Prajwal-Chandrashekhar-Wani/Pump-Lifting-Mechanism-/README.md

# Pump-Lifting-Mechanism-
This project focuses on the design and development of a manual/mechanically operated pump lifting mechanism for safe and efficient removal or installation of submersible pumps in Well and Borewell
