Prajwal-Chandrashekhar-Wani/Pump-Lifting-Mechanism-/Design and Analysis of a Tractor1.pdf

# Vishwakarma Institute of Technology

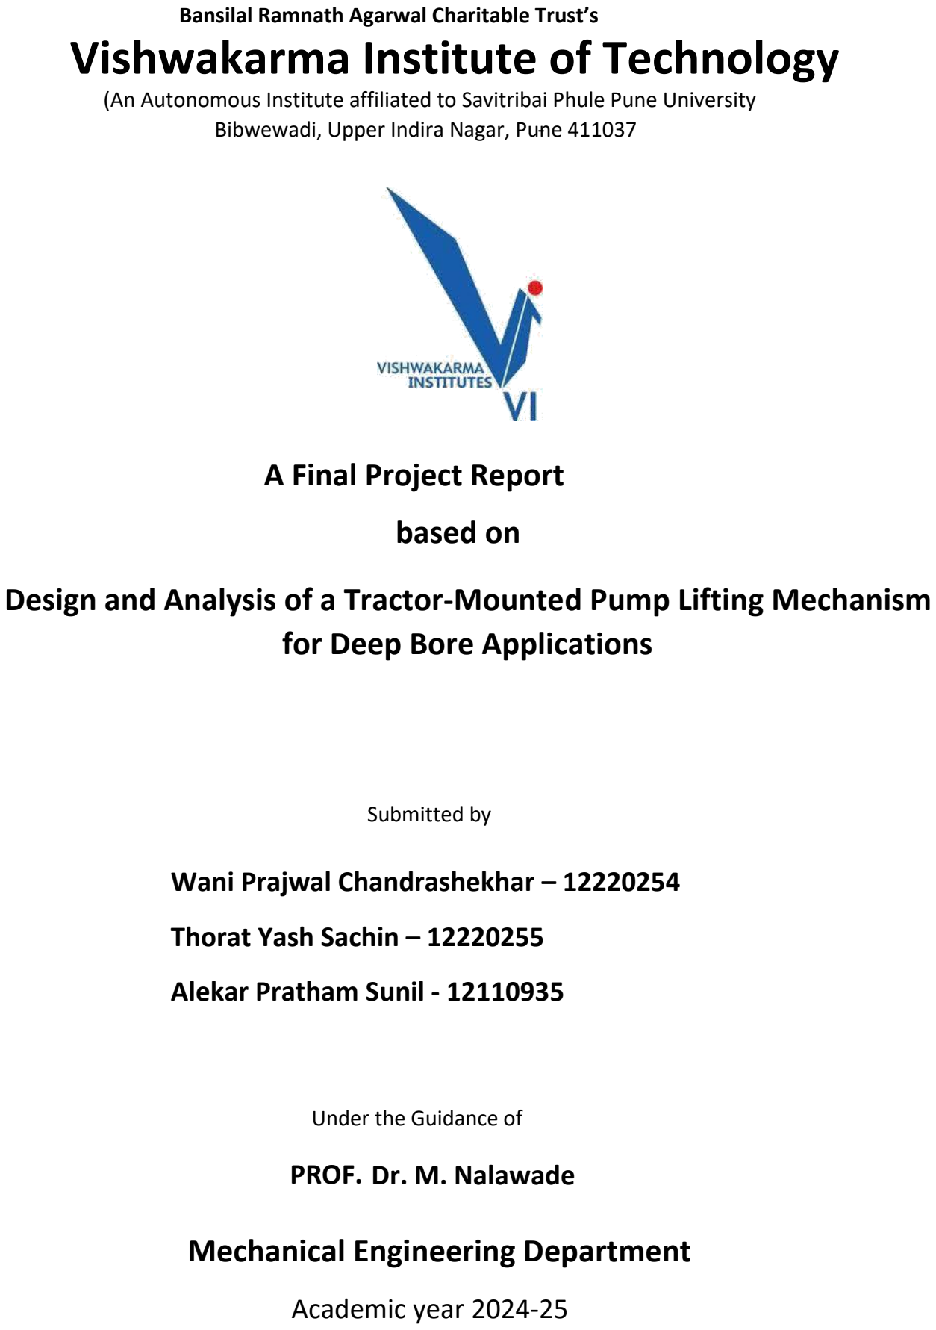
[picture p1: page 1]

Bansilal Ramnath Agarwal Charitable Trust’s

(An Autonomous Institute affiliated to Savitribai Phule Pune University Bibwewadi, Upper Indira Nagar, Pune 411037 -

## A Final Project Report

## based on

## Design and Analysis of a Tractor-Mounted Pump Lifting Mechanism for Deep Bore Applications

Submitted by

### Wani Prajwal Chandrashekhar – 12220254

### Thorat Yash Sachin – 12220255

### Alekar Pratham Sunil - 12110935

Under the Guidance of

### PROF. Dr. M. Nalawade

## Mechanical Engineering Department

### Academic year 2024-25

BANSILAL RAMNATH AGARWAL CHARITABLE TRUST’S

### VISHWAKARMA INSTITUTE OF TECHNOLOGY

PUNE-411 037

(An Autonomous Institute Affiliated to Savitribai Phule Pune University)

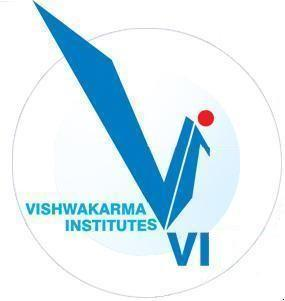
[picture p2: figure]

CERTIFICATE

This is to certify that the Project titled “Design and Analysis of a Tractor-Mounted Pump Lifting

Mechanism for Deep Bore Applications” has been completed in the academic year 2024 – 2025, by WANI

PRAJWAL CHANDRASHEKHAR (GR No: 12220254, Roll NO: 88), in partial fulfilment of B. Tech in Mechanical

Engineering as prescribed by Savitribai Phule Pune University.

Prof. M. Nalawade
Institute Guide,
Examiner | Prof. (Dr.) D. B. Hulwan Head of Department,
| Mechanical
Place: Pune | Date: /5//2025

# ACKNOWLEDGMENT

I would like to express my deepest gratitude to Dr. D. B. Hulwan, Head of the Department of Mechanical Engineering, for his unwavering support, guidance, and for granting me the permission to undertake this project. His encouragement and leadership have been instrumental in shaping the direction and success of this endeavor.

### My heartfelt thanks also go to Prof. (Dr.) M. Nalawade, Project Coordinator and College

Guide at Vishwakarma Institute of Technology, for his invaluable mentorship throughout the course of this project. His expert advice, constant encouragement, and constructive feedback greatly enhanced the quality of my work. I am truly fortunate to have worked under his guidance.

I am also grateful to all the faculty members and staff of the Mechanical Engineering Department for their support, insights, and for providing a learning environment conducive to innovation and growth.

I would like to extend special thanks to all those who, directly or indirectly, contributed to the successful completion of my final year project. Their assistance, encouragement, and cooperation made a significant difference in overcoming the challenges faced during various stages of the project.

### This project has provided me with a unique opportunity to apply theoretical knowledge to

practical scenarios. The skills, insights, and hands-on experience I have gained throughout this journey will be cherished and will continue to influence my professional and academic growth in the years to come.

Finally, I am thankful to my peers, friends, and family members whose moral support and motivation helped me stay focused and driven throughout these endeavours.

## Article

## Design and Analysis of a Tractor-Mounted Pump Lifting Mechanism for Deep Bore Applications

Wani Prajwal ¹

, Thorat Yash ²

, Alekar Pratham ³

, Nalawade Mukund ⁴

1. Vishwakarma Institute of Technology, Mechanical dept. Pune, India prajwal.wani22@vit.edu
2. Vishwakarma Institute of Technology, Mechanical dept. Pune, India yash.thorat22@vit.edu
3. Vishwakarma Institute of Technology, Mechanical dept. Pune, India pratham.alekar21@vit.edu
4. Vishwakarma Institute of Technology, Mechanical dept. Pune, India nalwade.mukund22@vit.edu
- Correspondence: prajwal.wani22@vit.edu

Featured Application: The current research may serve as a reference to the loading and lifting equipment Design and Analysis of a Tractor-Mounted Pump Lifting Mechanism for Deep Bore Applications

Abstract - Submersible pumps installed for farming irrigation through borewells tend to have to be withdrawn from time to time for upkeep. Conventional manual lifting proves to be an energy-intensive process. This work brings forth the design and testing of a half-automatic tractor- mounted pump lift system specifically adapted to deep bore use. The mechanism uses a PTO-powered rope drum, bevel gear system, and worm and worm wheel setup to hoist loads of 150 kg at a depth of 100 feet. The 6×19 IWRC steel wire rope was chosen for strength, fatigue, and abrasion. The torque calculation, drum size selection, fatigue bending analysis, and rope selection were done in accordance with global standards. The mechanism provides a safe, energy-saving solution for remote or rural locations that maximizes both safety and maintenance ease.

Keywords: Semi-automatic lifting system, tractor PTO, borewell pump retrieval, steel wire rope design, agricultural engineering, rural water systems.

### Introduction

The design of effective and dependable lifting devices has been the subject of many studies in areas ranging from heavy construction, rural water supply, to automated material handling. Researchers have attempted structural optimization, dynamic control
systems, | safety | methods, | and | mechanical
advancements to enhance performance, save costs, and increase usability in real-world applications.

Reliability-based structural optimization has been an important research area in heavy lifting systems. A robust design optimization (RBDO) framework wasadopted for crawler cranes' lattice booms for which weight reduction was attained while not compromising on safety by combining probabilistic restrictions like strength, stiffness, overall stability, and compressive-bending reliability. The method also proved to efficiently achieve up to 9.62% reduction in weight by keeping the reliability index greater than 4.364, with still attaining a 2.8% reduction at an even more cautious reliability level, providing huge savings in material as well as costs [1]. (https://doi.org/10.1016/j.istruc.2020.12.024)

In crane operation and motion control, dynamic modeling with wire rope elasticity was brought into play to improve the simulation of crane behavior under sophisticated conditions. This model enabled the creation of high-performance robust sliding mode control (SMC) algorithms such as standard, terminal, and fast terminal SMC that handled multiple degrees of freedom like boom luffing, cargo-lifting, and swing suppression at the same time. [1]. (https://doi.org/10.1016/j.istruc.2020.12.024) These strategies showed high precision in motion coordination while minimizing oscillations, ensuring system stability in dynamic environments [2]. (https://doi.org/10.1016/j.ymssp.2017.09.045)

Crane safety has also been extensively reviewed, highlighting a gap in the attention given to non-technical risk dimensions. While equipment-related hazards were well covered, other factors such as operator behavior, environmental conditions, and regulatory deficiencies received relatively little scholarly focus. Eight significant research gaps were
identified, | urging | a | shift | toward | a | more
multidisciplinary approach in crane safety research to better prevent accidents and improve operational guidelines [3]. (https://doi.org/10.1016/j.ssci.2020.105002) Complementary to this, practical literature has provided detailed engineering insights into components such as wire ropes, drives, and
maintenance | practices, | supporting | the
implementation of safer and longer-lasting crane systems [4]. (https://www.wiley.com/en-us/Cranes%3A+Design%2C+Practice%2C+and+Maintenance%2C+2nd+Edition-p-9781860583735)

Parallel advancements have been made in the field of pump and water lifting mechanisms. A deep-sea motor pump utilizing an increased flowrate approach was designed to expand passage dimensions, enabling the transport of coarse particles and improving anti-blocking performance. A six-stage pump configuration was validated through experiments, confirming its ability to handle suspended particles without motor overload—demonstrating the design’s effectiveness in particle-laden environments [5]. (https://doi.org/10.1016/j.apor.2018.10.018)

Automation and predictability in small-scale lifting systems have also been examined. An electric motor power-driven, mechanical lift automation system with a 1-hp motor and a counterweight scheme was established in industrial material handling. The third-order polynomial character of the lift time vs load relationship and multiple operating zones present in the lift cycle were seen in experiment outcomes. This improves the understanding of load behavior trends and efficiency performance in low-capacity automated systems [6]. (https://www.researchgate.net/publication/342155446_Development_of_an_automated_mechanical_lift_for_material_handling_purposes)

Hydraulic lifting circuits widely employed by cranes are strongly affected by the mechanical properties of steel wire ropes. Investigation showed that the pre-tensioning of hoisting ropes has a remarkable effect on minimizing peak dynamic loads and stabilization
time—by | 92.6% | and | 49%, | respectively—
demonstrating the significance of wire rope layout in system dynamics. Comparatively, rope stiffness increase affected the system to a relatively lesser extent, demonstrating that initial tension is a more significant parameter for performance adjustment [7]. (https://www.researchgate.net/publication/348549539_Analysis_of_the_influence_on_the_hydraulic_lifting_circuit_of_the_boom_crane_when_the_characteristics_of_th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)

Applications of bore well have motivated various innovations with respect to affordability, portability, and simplicity. A low-cost compact bore well pump lifting mechanism was developed for rural and small-scale users with low cost and less labor demand. The system is effective in enabling easy installation and removal of submersible pumps, thereby lessening the reliance on manual processes [8]. (https://www.jetir.org/papers/JETIR1904995.pdf) In another connected development, a wind-energy-water-lifting-pump mechanism was suggested, employing rotating foils and a piston-linear drive to harness the mechanical energy of the wind as a means to extract usable water—acting as a renewable solution to far-off water acquisition [9]. (https://ijste.org/articles/IJSTEV2I12236.pdf)

To surpass the shortcomings of conventional lifting systems, a review of bore well pump installation methods cited disadvantages in mechanisms such as chain pulleys and hydraulic lifters. A recently suggested automated machine overcame such shortcomings with its compact size and tool-free assembly/disassembly, which suited confined or rural settings [10]. (https://ijsrd.com/articles/IJSRDV3I80018.pdf) The design was further improved upon with the creation of a gear-powered submersible pump lift machine that could lift pumps from 300 ft deep bore wells using only two workers. Working at a rate greater than 3 meters per minute, the machine was ten times more efficient than the conventional system and did not require any special tools—something that made it ideal for use in rural agriculture [11]. (https://matjournals.co.in/index.php/JoIM/article/view/6485)

The literature reviewed as a whole highlights the increasing interest in improving efficiency, safety, and automation in bore well operations and farm machinery, especially in pipe lifting mechanisms and tractor-based systems.

Bajbalkar and Bhajibhakare et.al [12] (https://ijariie.com/AdminUploadPdf/Review_on_Modeling_of_Mechanism_for_Installation_and_Lifting_of_Bore_Well_Pipe_and_Submersible_Pump_ijariie9894.pdf) propose an inclusive summary of present techniques of installation and hoisting of bore well pipes and submersible pumps, identifying major disadvantages of available methods, which are very manpower-intensive, time-consuming, and inefficient. They stress the imminent need for a compact, affordable mechanism to minimize manpower and cost of operations. Similarly Choure and Kale [17] (https://ijariie.com/AdminUploadPdf/Review_on_Bore_Well_Pipe_Lifting_and_Transportation_Machine_ijariie8295.pdf) suggest a motor-operated bore well pipe lifting and transporting machine, having a gear and roller operated lifting mechanism.The mechanism lifts automatically at a speed of more than 3 meters per minute, lifts the load of 100 to 1000 kg, and has the features of safety devices such as adjustable pressure rollers and a worm gearbox. Its simplicity is low-cost and appropriate for rural and limited-space operations, providing a significant improvement over conventional chain pulley system.

Moving to farm machinery, Cong et al. [13] (https://www.mdpi.com/2076-3417/11/20/9758) discuss the shortcomings of traditional testing techniques for hydraulic linkages in high- and medium-horsepower tractors. They created a test device using a four-bar mechanism to assess load-lifting performance. The system decreases detection time considerably and does away with manual connection between the tractor and the load, thus enhancing efficiency and safety in hydraulic system testing. Structural optimization and analysis, Tarighi et al. [14] (https://www.researchgate.net/publication/288920111_Optimization_of_a_Lower_Hitch_Link_for_a_Heavy_Duty_Tractor_Using_Finite_Element_Method) used finite element analysis to find the optimal design for the lower hitch link of a heavy-duty tractor. Two materials, CK45 and 945M38, were compared under the same stress conditions. Although both materials were able to endure one million cycles of loading, 945M38 showed a much greater factor of safety (5.13) and hence is an appropriate material for durability and reliability under tough, demanding applications. Likewise, Seyedabadi
[15] (https://link.springer.com/article/10.1007/s11668-015-0010-0) performed a finite element analysis of the MF-285 tractor lift arm. The results showed that although the arm is safe for normal plow loads (500 kg), it is not structurally sufficient for the maximum hydraulic capacity of the tractor, which is 2230 kg. The research advises either reducing the lifting capacity to 1430 kg, thus having a minimum safety factor of 1.5, or re-engineering the lift arm for increased strength.

In addition, Bentaher et al. [16] presented a new instrumentation system for the three-point hitch mechanism of tractors to optimize tillage operations. The system uses only three force transducers to measure the three orthogonal components of tillage force—longitudinal, lateral, and vertical. A key advantage of this system is its ability to detect asymmetrical loading caused by implements like mouldboards, through differences in the lift arm reactions. Calibration results confirmed its accuracy, with errors below 2.8% for vertical force measurements and a maximum of 13% for the lowest force, demonstrating the system’s practicality and reliability in field applications.

### Device Design

The Tractor (model 5050E, JOHN DEERE) widely used in large and medium horsepower tractors is adopted during the present study. The lifting torque and Speed range of the device used in the test is 126Nm and 540rpm.

Test Requirements | Index
Maximum Weight to Lift | 150 kg
Lifting Height | 100 feet
Maximum Lifting Torque | 126Nm
Speed | 2100rpm

Principle of Design:

Based on field observations and insights from relevant literature, the process of lifting submersible pumps from deep bore wells involves two primary stages: the connection of the lifting mechanism to the pump assembly and the subsequent lifting operation. The initial stage includes securely attaching the lifting rope or hook to the pump or pipe. The mechanism designed in the present study is mounted on a tractor and focuses on providing a simple, safe, and efficient solution for lifting pumps without the need for manual excavation or trenching at the bore site. This not only enhances safety but also minimizes site disruption during pump installation and retrieval.

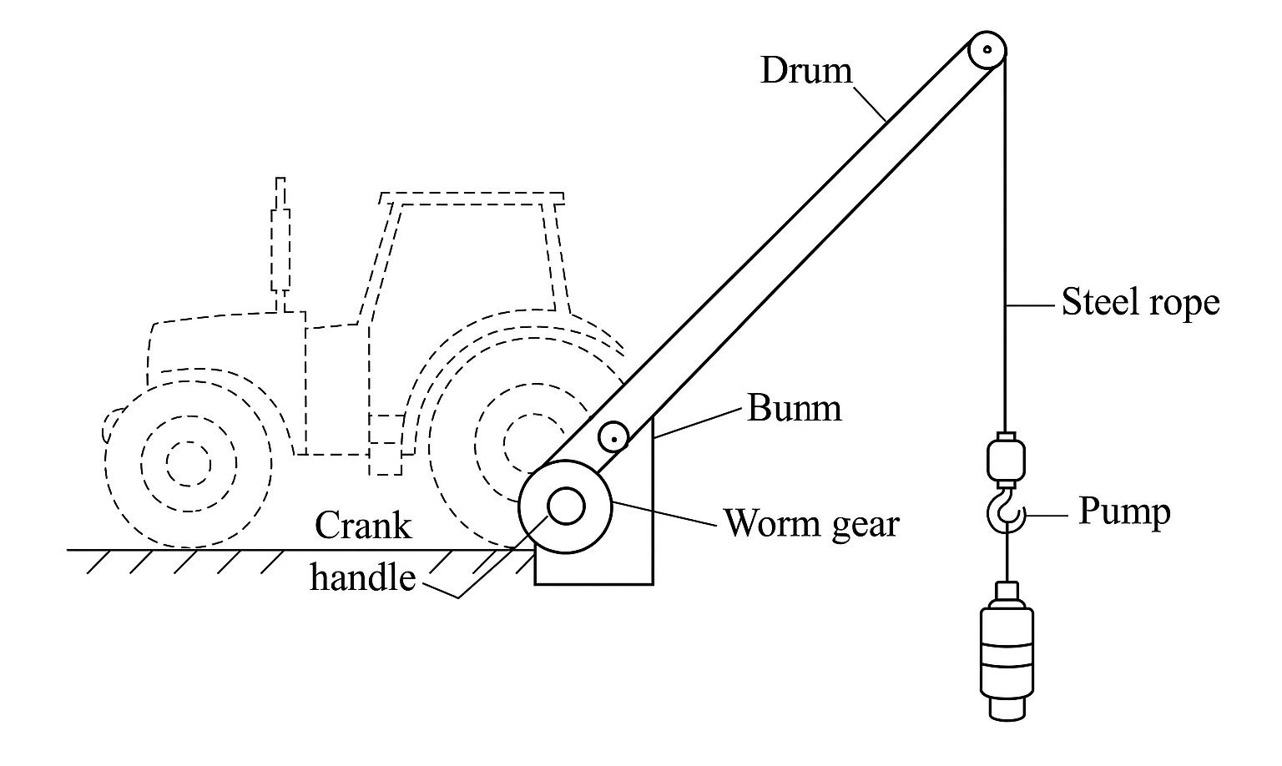
[picture p3: figure]

Fig no: 1 Design Assembly of Tractor Mounted Pump Lifting Mechanism

### Components to Design: -

PTO Shaft, Worm & Worm Wheel, Bevel Gear, Spline, Hand Lever, Drum, Steel Rope, Pulley, Crane Boom.

Work on Design Data
Pump to Lift | 150Kg (1470.9975N)
Depth | 100feet (30.48m)
Tractor Torque | 126Nm
Hand Torque | -
Table no 1: Design Data

The weight of the Pump that is transferred through the pulley

Work on the Design Data of Pulley Load
Coefficient of Friction (μ) | 0.3
Tmin | 1471N
Contact | 135Deg
Tmax | 2651.1N
Table no 2: Design Data of Pulley
Rope Material | Rope Material | Rope Material
Steel rope on steel pulley (dry) | Steel | 0.15 to 0.25
Steel rope on steel pulley (oil) | Steel | 0.05–0.08
Nylon rope on steel pulley | Steel | 0.08 to 0.15
Cotton rope on wood pulley | Wood | 0.25-0.4
Table no 3: Steel Rope Friction Factor

Tmax

Tmin

= e

μ.θ

Tmax
1471 = e

0.25×135×(

3.14
180)

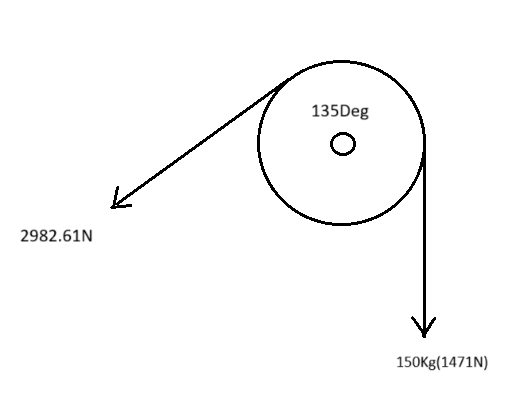
[picture p4: figure]

Fig no 2: Friction in Rope and Pulley

### 1. PTO Shaft: -

Power (KW) | 27.6
Speed (rpm) | 2100
Torque (Nm) | 126

Table no 4: PTO Shaft Design Data

Torque (Nm) =

9550 × Power (kW)
Speed (rpm)

Torque (Nm) =

9550 × 27.6
2100

Torque (Nm) = 126Nm

Maximum Length of Shaft: | 1447.8 (57")
Minimum Length of Shaft: | 889mm (35")

Table no 5: Length of PTO Shaft

Where ,

D = major diameter of splines (mm) | d = minor diameter of splines (mm)
l = length of hub (mm) | n = number of splines
Mt = transmitted torque (N-mm) | pm = permissible pressure on spline (N/mm2)
A = total area of splines (mm2) | Rm = mean radius of splines (mm)

The Permissible pressure on the Splines is Limited to 6.5 N/mm²

Mt =

1
8

pm ln (D

2 − d

2
)

Mt =

1
8

6.5 × 76 × 6 (34.87² − 27.89² )

Mt = 162303 Nmm << 126000 Nmm

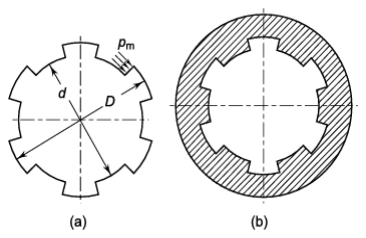
[picture p5: figure]

Fig no 3: Spline Dimensions

Assume allowable shear stress τmax = 40 MPa = 40 N/mm2 (typical for mild steel in conservative design)

T =

π
16

× τ ×

D

4 − d

4
D

126000 =

π
16

× 40 ×

D

4 − 29.65⁴
D
D = 38.08 mm

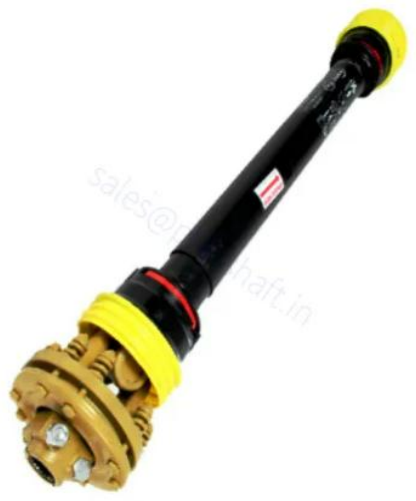
[picture p6: figure]
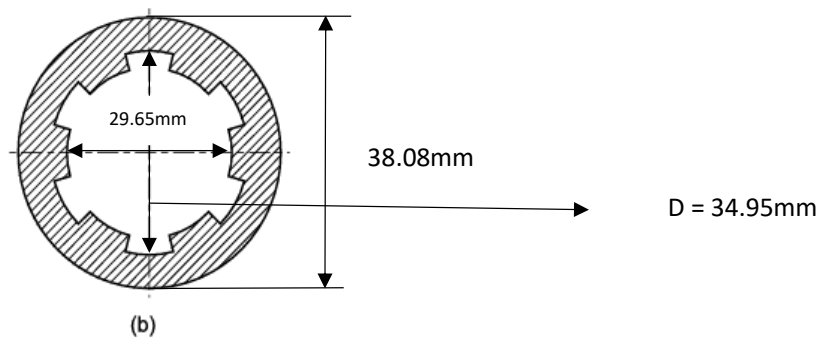
[picture p7: figure]

Fig no 4: Actual Spline Design for PTO Shaft | Fig no 5: How Actually a PTO Shaft Looks

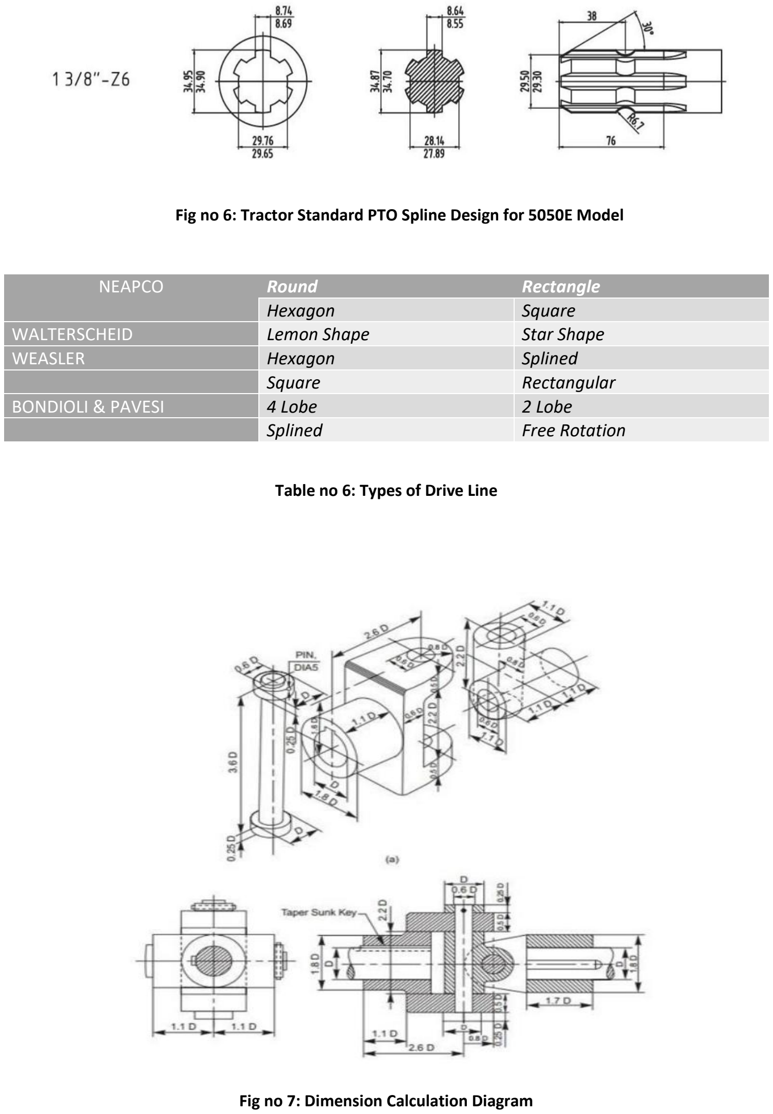
[picture p8: page 10]

Fig no 6: Tractor Standard PTO Spline Design for 5050E Model

NEAPCO | Round | Rectangle
Hexagon | Square
WALTERSCHEID | Lemon Shape | Star Shape
WEASLER | Hexagon | Splined
| Square | Rectangular
BONDIOLI & PAVESI | 4 Lobe | 2 Lobe
| Splined | Free Rotation

Table no 6: Types of Drive Line

Fig no 7: Dimension Calculation Diagram

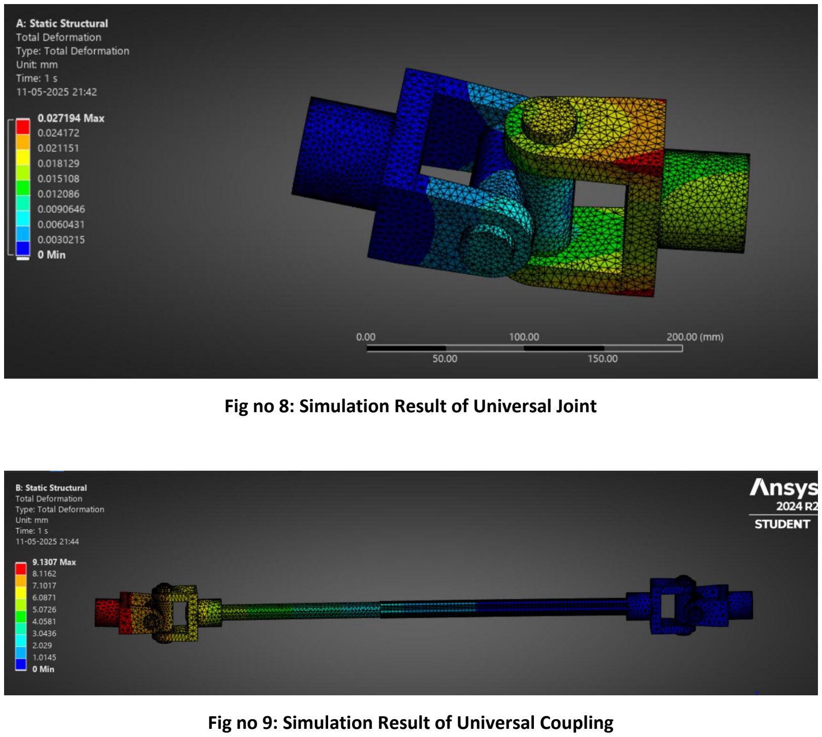
[picture p9: page 11]

### Fig no 8: Simulation Result of Universal Joint

### Fig no 9: Simulation Result of Universal Coupling

### 2. Steel Rope:

### Standard Nominal Tensile Strengths of Wire Rope Wires

Grade | Nominal Tensile Strength (N) (MPa) | Common Use
1370 | 1370 MPa | Light applications, low-load hoisting
1570 | 1570 MPa | General lifting, moderate stresses
1770 | 1770 MPa | Heavy lifting, cranes, construction
1960 | 1960 MPa | Very heavy lifting, elevators, mining
2160 | 2160 MPa | Special Purpose (e.g. high rise Crane)

Table no 7: Tensile Strength of Steel Wire based on Grade

### Steel Wire Rope Design Calculation Process

### 1. Determine Required Load Capacity

The first step is to calculate the Minimum Breaking Load (MBL) based on the working load.

### MBL = SF × WLL

### Where:

### MBL = Minimum Breaking Load (kN)

### SF = Safety Factor (typically 5 to 8 for lifting applications)

### WLL = Working Load Limit (kN)

### MBL = 2651.1 × 5 = 13.26KN

### 2. Select Wire Rope Diameter

The approximate breaking strength (BS) of a steel wire rope is calculated using the empirical

### formula:

### BS = 0.38 × d

2 × N
24.21 = 0.38 × d

2 × 1570

### d = 6 mm BS > MBL

### 3. Calculate Rope Weight The weight of the rope per meter can be estimated as

W = 0.034 × d

2
Where W is the weight in kg/m and is the diameter in mm. W = 0.034 × 6

2

### W = 1.224kg/m

### 4. Calculate Fatigue Life:

### Number of Bends Per Cycle: 1 bend over the pulley 1 bend while winding on the drum Total bends per cycle = 2

### Empirical Fatigue Constants (for wire rope, typical values from ISO 4309 & ASME B30.9): C = 10^7(for steel rope, empirical constant) b = 3 (for bending fatigue)

### Nf = C × (

D
d

)

### For Pulley bending:

### Nf = 10⁷ × (

200
6

)

### Nf = 3 × 10⁸Cycle

### For Drum Winding

### Nf = 10⁷ × (

200
6

)

3

### Nf = 3.70 × 10¹¹ Cycle

### Both Combine

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
3 × 10⁸ +

1
3.70 × 10¹¹

### Nf= 2.997 × 10⁸ cycles

The expected fatigue life is approximately 300 million cycles.
This is a theoretical value assuming ideal conditions. In real-world applications, abrasion, corrosion, and dynamic loading reduce fatigue life significantly.

Type | Wire per Strand | Total Wires | Flexibility | Abrasion Resistance | Fatigue Resistance | Typical Uses
6×7 | 7 | 42 | Low (Stiff) | Very High | Low | Guy Wires, Low Bending
6×19 | 19 | 118 | Medium | High | Medium | Cranes, Pump Lifting
6×25 | 25 | 150 | Medium-High | Medium | Good | Elevators, Crane, Lifting
6×36 | 36 | 210 | High | Medium -Low | High | Mobile cranes, Winches, Pulleys
7×19 | 19 | 197 | Very High | Low | High | Aircraft cables, garage doors
8×19 | 19 | 152 | Very High | Medium – Low | High | Mine hoists, marine uses
8×36 | 36 | 288 | Very High | Low | Very High | Slings, heavy cranes, drag lines.

Table no 8: Types of Steel Wire and its Applications

Core Type | Description | Usage
FC (Fiber Core) | Natural/synthetic fiber core; more flexible, but lower strength. | Light-duty applications.
IWRC (Independent Wire Rope Core) | Steel strand core; higher strength and heat resistance. | Heavy-duty lifting, cranes, high-load situations.

Table no 9: Core Type Steel Rope

### Core Selection:

- Fiber Core (FC): Made from natural or synthetic fibers, offering flexibility but less strength.

### - Steel Core:

- Wire Strand Core (WSC): Consists of a single steel strand.

### - Independent Wire Rope Core (IWRC): Comprises a small wire rope, enhancing

strength and resistance to crushing.

### Considerations:

- Fiber Core: Suitable for applications requiring flexibility and where the rope isn't subjected to high temperatures or crushing forces.

### - Steel Core: Ideal for heavy-duty applications, providing higher strength and better

resistance to compression and high temperatures.

### Based on Rope Diameter Proportions

These are rough empirical rules derived from wire rope design standards (e.g., ASTM, ISO):

Component | Formula | For 6 mm Rope
Strand Diameter | 0.65 × D | 0.65 × 6 = 3.9 mm
Center Wire | 0.20 × D | 0.20 × 6 = 1.2 mm
Outer Wire | 0.18 × D | 0.18 × 6 = 1.08 mm
Inner Wire | 0.14 × D | 0.14 × 6 = 0.84 mm
IWRC Core Diameter | 0.4 × D | 0.4 × 6 = 2.4 mm

Table no 10: Wire Thickness Calculation

### This is a common layout for a 19-wire strand: - 1 center wire - 6 wires in the first layer - 12 wires in the outer layer Total = 1 + 6 + 12 = 19 wires per strand So for 6 strands, you'll have: - 6 × (1 + 6 + 12) = 114 wires

### 7×7 means: - 7 strands - Each strand has 7 wires (1 center + 6 around)

### - Total: 49 wires

Component | Description
Outer Rope | 6 strands × 19 wires = 114 wires
IWRC (core) | 7×7 = 49 wires
Total wires | 114 + 49 = 163 wires
Core diameter | ≈ 2.4 mm

Table no 11: Wire of Rope

### Step 1: Estimate strand diameter in 7×7 - Strand count = 7 - Typical rope structure: rope diameter ≈ 3 × wire diameter (for small constructions) - More accurately, strand diameter ≈ 0.65 × IWRC diameter

### Strand diameter ≈ 0.65 × 2.4 ≈ 1.56mm

### Step 2: Estimate wire diameter - Each strand has 7 wires in 1+6 pattern - Strand diameter ≈ 3 × wire diameter (approx for 1+6)

### Wire Diameter =

1.56
3

= 0.52mm

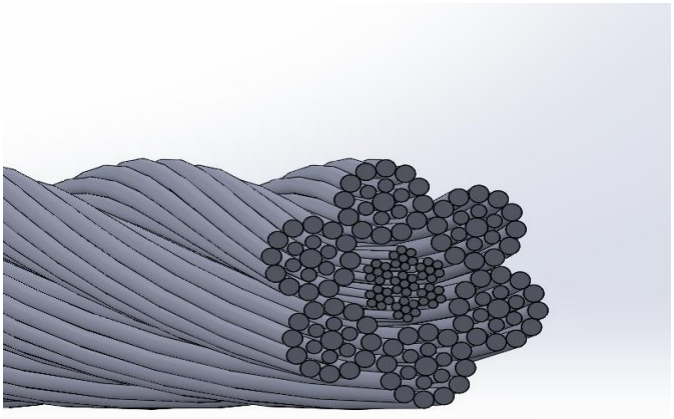
[picture p10: figure]

### Fig no 10: Design of Steel Rope

### 3. Bevel Gear Design:

### 1. Design Requirements

### Input Torque = 126 Nm

### Output Torque = 126 Nm

### Gear Ratio = 1:1

### Shaft Angle = 90°

### Material: AISI 1045 Steel, Allowable Bending Stress ≈ 100MPa

### Service Factor: 1.25 (For Moderate Load)

### 2. Select Number of Teeth

### To avoid undercutting, minimum teeth on pinion (Straight Bevel) = 16

### Pinion Teeth: Z1 = 20

### Gear Teeth: Z2 = 20

### 3. Determine Pitch Angles

For Equal Gear sizes and 90° Shaft angle.

Δ1 = Δ2 = 45°

### 4. Section Modulus We’ll choose a modulus that support 126 Nm Safely

### Try module m = 5mm

### Then Pitch Diameter:

### d = m × Z = 5 × 20 = 100 mm

### Tangential radius: r = 50 mm = 0.05 m

Ft =

126
0.05

= 2520 N

### 5. Face Width (b)

### Standard Face Width:

b = ¹
3

d =

1
5

× 100 = 20mm

### 6. Check Bending Strength Using

σ =

Ft
b×m×Y

=

2520
20×5×0.5

### = 50.4 MPa

### 7. Addendum (a)

### 1 × m = 5mm

### 8. Dedendum (da) 3.25.1 × m = 6.25mm

### 9. Outer diameter (da)

### d + 2a = 110mm

### 10.Root Diameter (dr)

### dr = d – 2da = 100 - 2×6.25 = 87.5mm

### 11.Cone Distance ®

R = d
2sin∆

=

100
2sin45°

= 70.71mm

### 12.Back Cone angle (β)

. β= 90° - Δ = 45°

### 13.Face Angle

### Δ + tan⁻¹

b
R

### = 45°+tan⁻¹

20
70.71

= 61°

### 14.Root Angle

### Δ – tan⁻¹

b
R

### = 45°-tan⁻¹

20
70.71

= 29°

### 15.Clearance ©

### 0.25 × m = 0.25 × 5 =1.25mm

### Shaft Hole Design

### Based on Torque

dsℎaft = (

16T

π × τallow

)

1/3

### Assume allowable shear stress τ = 40 MPa

dsℎaft = (

16×126
π×40×10⁶

)

1/3 = 21.5mm

### Using Shaft hole = 25mm Diameter

### Keyway Dimensions (per ISO 773)

### For 25 mm Shaft

### Width = 6 mm

### Depth = 3.3 mm

### Key Length = 20-30 mm

### Hub Diameter

### 45 mm or More

### Hub Length

### Equal to Shaft Diameter

25-30mm

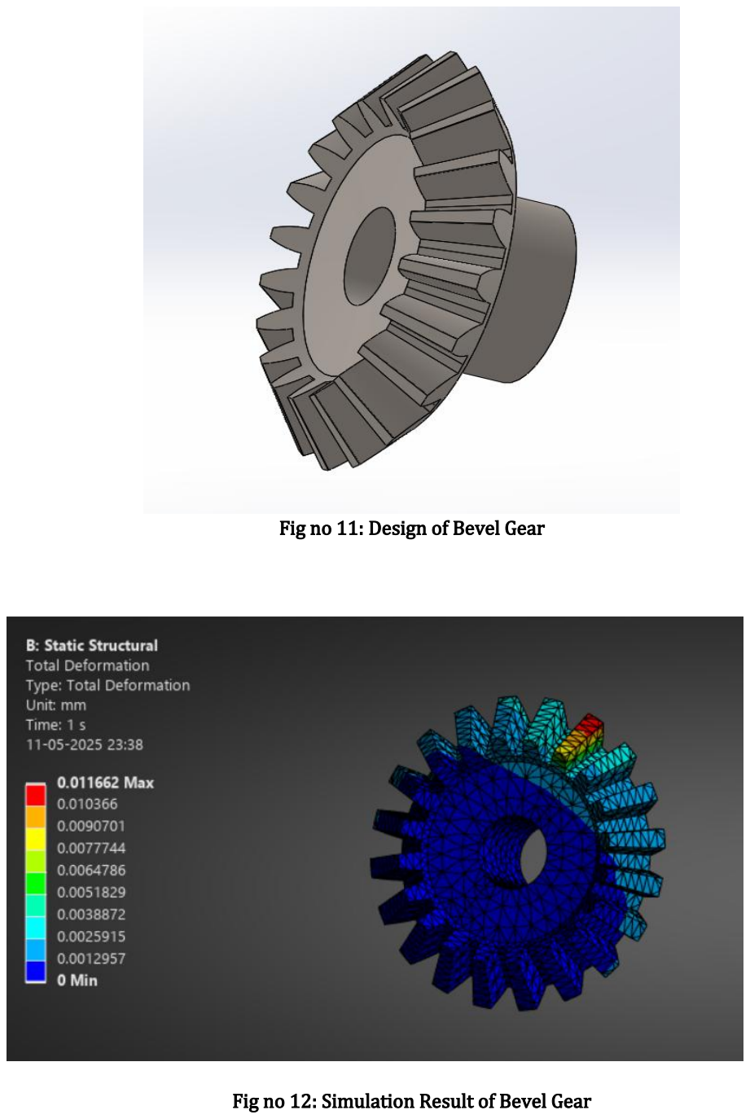
[picture p11: page 20]

### Fig no 11: Design of Bevel Gear

### Fig no 12: Simulation Result of Bevel Gear

### 4. Drum Design:

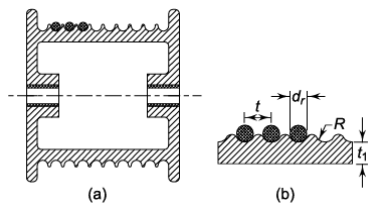
[picture p12: figure]

Fig no 13: Drum Design

### Rope Diameter of 10 mm (dr)

### t = dr + (2 to 3 mm)

### t1 = 0.02 D + (6 to 10 mm)

### Groove radius = 1.05 (nominal rope radius)

### D = Drum Diameter (mm)

### Data:

### Drum Diameter (D) = 200 mm

### Drum Width (W) = 300 mm

### Rope Diamter (d°) = 10 mm

### t = 10 + 2 = 12 mm

### t1 = 0.02 × 200 + 6 = 10 mm

### Torsional Shear Stress in Shaft

### F = 2651 N – if we Consider Friction

### T = 2651 N × 0.1 m = 265.1 Nm

### Groove radius = 1.05 × 10 = 10.5mm

### If shaft Diameter is 25 mm

τtorsional =

16T
πd³

=

16 ×265.1×1000
π×25³

### = 86.40 Nmm

To use Material as Medium Carbon and Alloy Steel.

### For Bending Stress for 25 mm diameter Shaft

σbending =

32×M
π×d³

### M = 397.65 Nm = 397650 Nmm

### d = 25 mm

σbending =

32×397650
π×25³

### = 259.3 MPa

### For this Bending Stress Material should be Used is Medium Carbon and Alloy Steel

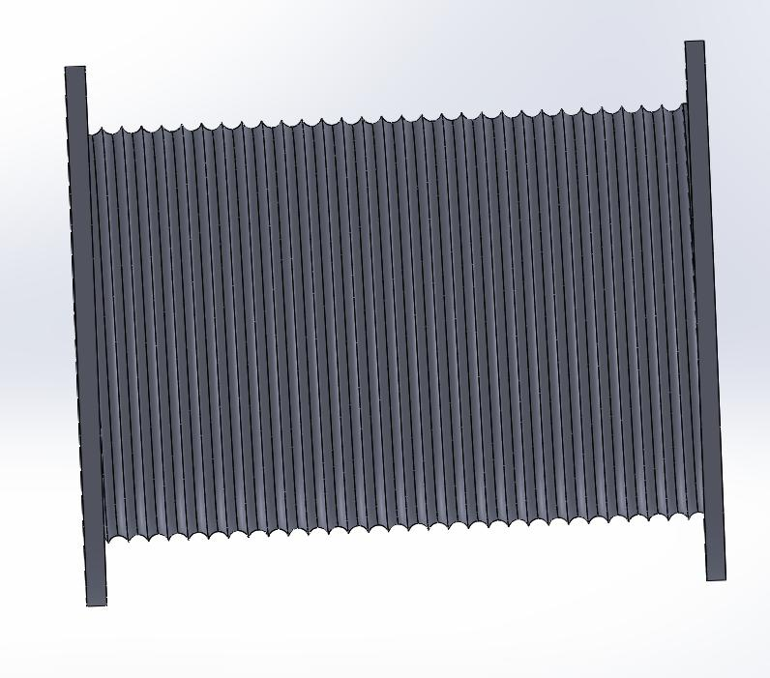
[picture p13: figure]

### Fig no 14: Design of Drum

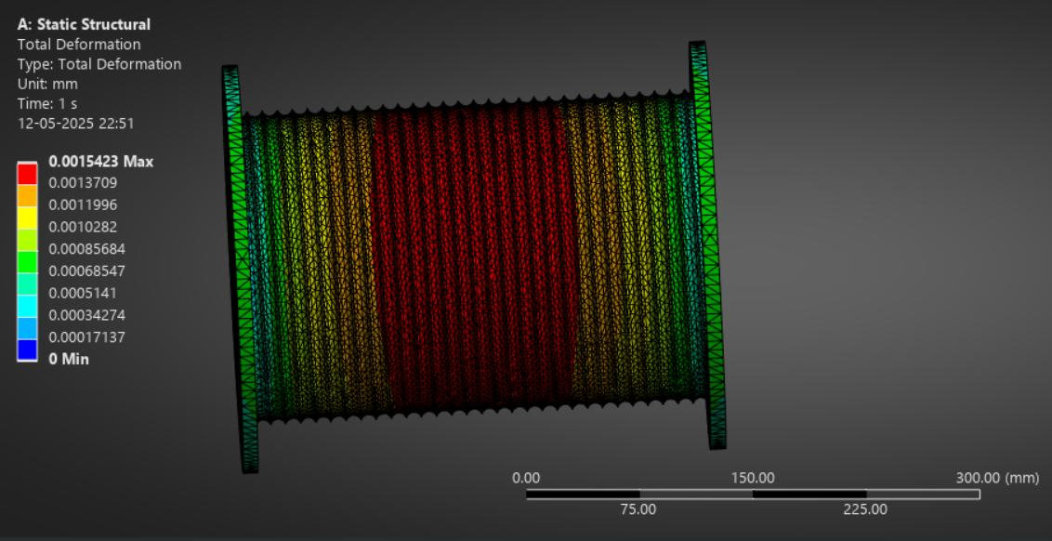
[picture p14: figure]

### Fig no 15: Simulation Result of Steel Rope Drum

### 5. Pulley Design: -

### Basic Parameters:

### Load (W) = 153 × 9.81 = 1501.9 N

### Rope Diameter (d0) = 10 mm (Wire Rope)

### Minimum Drum/Pulley Diameter (Dp) >= 20 × d0

### Pulley Diameter (Dp) = 20 × 10 mm = 200 mm

### Pulley Groove

### Groove Angle = 40° to 45°

### Groove Radius R = 0.53 × Rope Diameter = 0.53 × 10 = 5.3 mm

### Groove Depth = 1.5 × Rope Diameter = 1.5 × 10 = 15 mm

### Pulley Width (b)

### b = Rope Diameter + 2 × Flange Thickness + Clearance

### Suggestion: b = 35 to 50 mm (Safe for 10 mm rope)

### Shaft: - 25mm – Diameter

### Material: - Mild Steel or CI

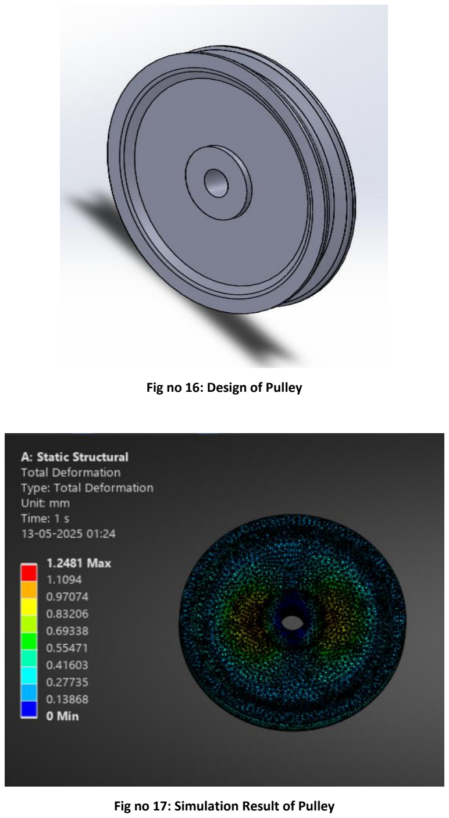
[picture p15: page 25]

### Fig no 16: Design of Pulley

### Fig no 17: Simulation Result of Pulley

### 6. Pulley Shaft:

### Requirement: -

### Length = 200 mm

### Load = 153 Kg = 153 × 9.81 = 1502 N

### Load Applied at Centre

### Material: - Mild Steel (Yield Strength = 250 MPa)

### Safety Factor: 3

### To Find Minimum Safe Diameter to resist:

### 1.Bending Stress

### 2.Shear Stress

### 1. Bending Moment at Centre:

M =

F ×L
A

=

1502 ×0.2
4

= 75.1 Nm

### 2. Section Modulus for a Circular Rod:

Z = πd³

32

### 3. Bending Stress:

σb =

M
Z

=

32 M
πd³

=

32 ×75.1
πd³

=

2403.2
πd³

### 4. Shear Stress:

τ =

4 × F
3×π ×d²

=

4 × 1502
3×π ×d²

=

2002.7
π ×d²

### 5. Combined Stress Check

### σeq = √σb

2 + 3τ
2 <=

σyield
SF

=

250
3

### = 83.3 MPa

### Try d = 20 mm

σb =

2403.2
π×20³

### = 9.55 MPa

τ =

2002.7
π×20²

### = 1.59 MPa

### σeq = √(9.55)

2 + 3 × (1.59)

### 2 = √91.2 + 7.6 = 9.98 MPa

### Well Below 83.3 MPa

### Minimum safe Diameter = 20mm

### We take as 25 mm

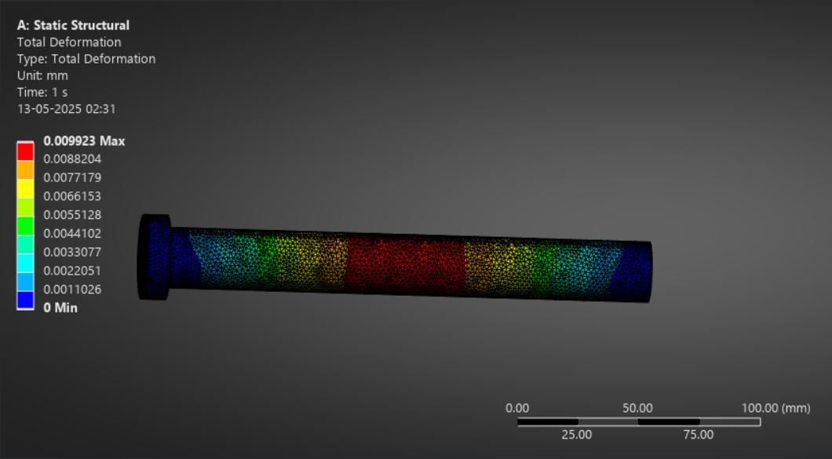
[picture p16: figure]

### Fig no 18: Simulation Result of Pulley Shaft

### 7. Worm And Worm Wheel Design: -

To design a worm and worm wheel system where the output torque on the worm wheel is 126 Nm

1. Define Gear Ratio (i)

i =

T
Z
For Single Start Worm (Z = 1), i = T
Lets Assume I = 30 (Common for Lifting Applications)

### 2. Find input Torque on Worm

Tworm =

Twℎeel
i. Ƞ

### Twℎeel = 126Nm

I = 30

### Ƞ = Efficiency (typical value of worm gears 0.3 to 0.5; we will use 0.4 for conservation estimate)

Tworm =

126
30.0.4

=

126
12

= 10.5Nm

### Material Worm = Hardened Steel Worm Wheel = Bronze or Cast Iron

### Design Calculation

### 1. Gear Ratio and Teeth Selection Worm Starts = 1 Worm Wheel Teeth, T = i* 1 = 30 Teeth

### Module (m) Selection To transmit 126Nm torque

m = √
2.Twℎeel
φ.σallow

3

Assume,

### Face width factor, φ = 10 Assume Bending Stress = 100MPa

m = √
2.126∗10^3
10.100.10^6

3
= 0.63

### Use Standard module m = 2mm

Parameter | Formula / Assumption | Value
Module (m) | Selected standard | 2 mm
No. of Teeth (T) | Worm wheel | 30
Starts on Worm (Z) | | 1
Pitch Diameter of Wheel | dw=m⋅T | 2⋅30=60
Pitch Diameter of Worm | d1=m⋅Z⋅q | Let q = 10 ⇒ 2⋅1⋅10=20
Lead Angle (λ) | tanλ=Z⋅m/πd1 | tan⁡−1(0.0318)≈1.82∘
Center Distance (a) | a=d1+dw/2 | (20 + 60)/2 = 40 mm
Face Width of Worm Wheel b=(9−10)⋅m | 18–20 mm
Length of Worm | l=(Z+2)⋅m=3⋅2 | 6 mm (min)
Component | Dimension
Module (m) | 2 mm

### Teeth on Wheel 30

Worm Starts | 1
Worm dia | 20 mm
Wheel dia | 60 mm

### Center Distance 40 mm

### Face Width 18–20 mm

### 8. Design of Crane Boom

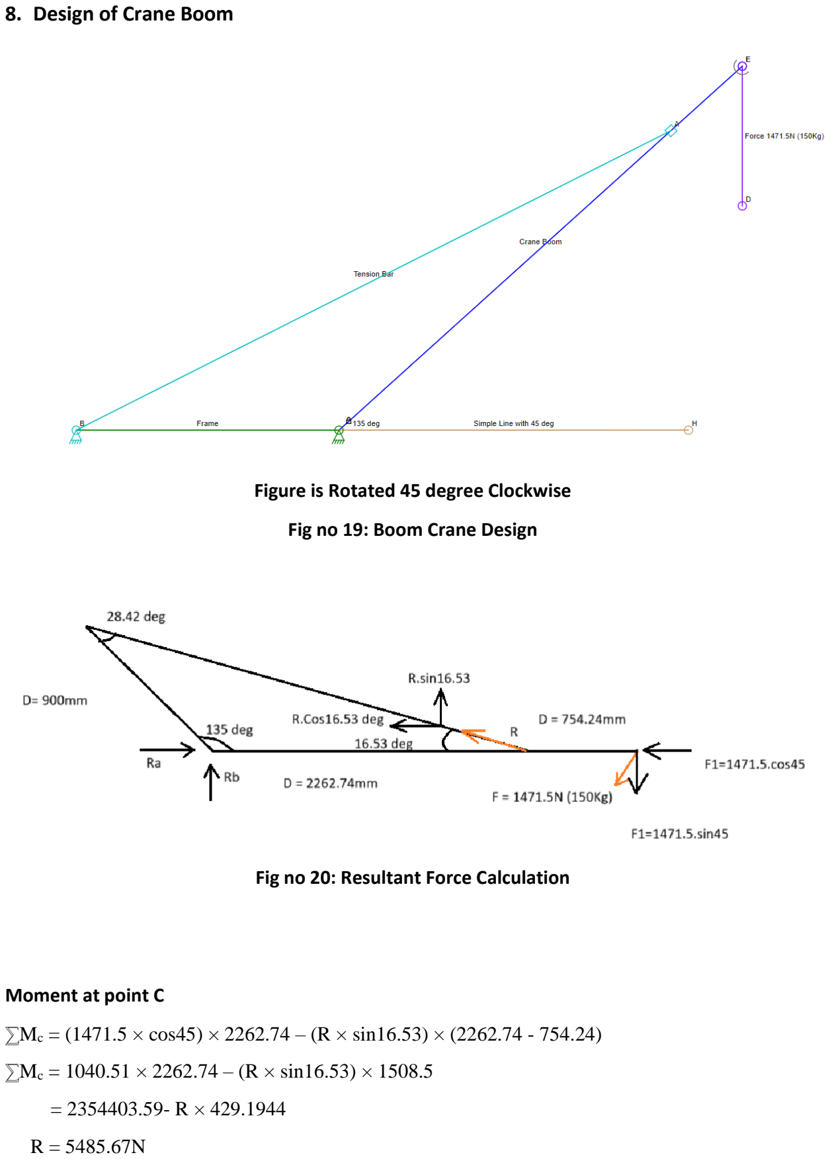
[picture p17: page 30]

### Figure is Rotated 45 degree Clockwise

### Fig no 19: Boom Crane Design

### Fig no 20: Resultant Force Calculation

### Moment at point C

⅀Mc = (1471.5 × cos45) × 2262.74 – (R × sin16.53) × (2262.74 - 754.24)

⅀Mc = 1040.51 × 2262.74 – (R × sin16.53) × 1508.5

= 2354403.59- R × 429.1944

R = 5485.67N

Forces:

R × Sin16.53 = 1560.77N

R × cos16.53 = 5258.95N

Boom Design Calculation:

### 1. Structural Analysis - Bending Moment & Shear

### It is a Cantilever Beam (X = 0) At this Step (X = 1508.49mm)

Moment due to 1040.51 N vertical load at x = 1508.49 + 754.24 = 2262.73 mm: M = 1040.51 × (2262.73 – 1508.49) = 1040.51 × 754.24 = 785255.9N/mm

Moment due to 1560.77 N upward force at x = 1508.49 mm:

M = −1560.77 × 0 = 0 (applied at pivot)

Moment due to horizontal 1040.51 N has no vertical moment effect

So, maximum bending moment at fixed support:

Mmax = 785255.9N/mm = 785.26N/m

### 2. Material properties (Assume it is Steel)

Parameter | Symbol | Value
Yield Strength | ƒy | 250Mpa
Elastic Modulus | E | 200Gpa
Allowable Stress | σallow | 150Mpa

Table no 12: Material Property for Boom Design

### 3. Section Modulus Required

Zreq =

Mmax

σallow

=

785255.9
150 = 5235 mm³

### 4. Select Rectangular Section

Z =

bℎ

2

6

> 5235
Assume width b = 50mm

50.ℎ

2

6

= 5235 = h² =

6.5235
50

### = 628.2 = ℎ = √628. 2 = 25.06mm

This is very small, so increase depth for stiffness and deflection control. Let's Choose:
b = 50mm
h = 100mm

Z =

50.100²

6

= 83333mm³

Much greater than Required so this Section is Safe in Bending.

### 5. Shear Stress Check

Shear force max = 5258.95N

Shear area: A = b. h = 50 × 100 = 5000mm²

Τavg =

V
A

=

5258.95
5000

= 1.0518MPa << 150MPa

Safe in Shear

### 6. Deflection Check

Δ = PL³

3EL

P = 1560.77N
L = 1508.493 mm
I = bℎ

3

12

=

50.100³

12

### = 4.17 × 10⁶ mm⁴

Δ =

1560.77.1508.493³
3 ×200000× 4.17×10⁶

= 2.14mm

Allowable(L/180) = 1508.493/180 = 8.380mm

Δ = PL³

3EL

P = 1040.51N
L = 2262.73 mm

I =

bℎ

3

12

=

50.100³

12

### = 4.17 × 10⁶ mm⁴

Δ =

1040.51×2262.73³
3 ×200000× 4.17×10⁶

= 4.82mm

Allowable (L/180) = 2262.73/180 = 12.57mm Safe in Deflection

### 7. Bending Stress Check

Max Moment
Mmax = 785.26N/m = 785260N/mm

Section Modulus:

Z = bℎ

2

6

=

50×100²

6

= 83333 mm³

Bending Stress:

σb =

M
Z

=

785260
83333

= 9.42 MPa

Compare with allowable
Mild Steel Yield: ƒy = 250 Mpa Allowable: σallow = 150 Mpa

Bending Stress is Safe

### 8. Shear Stress Check

Max Shear: Vmax = 1508.493N
Shear area: A = b × h = 50 × 100 = 5000mm²

Average Shear Stress:

τavg =

V
A

=

1508.493
5000

= 0.302 MPa

Shear Stress is Safe

### 9. Axial Compressive Stress:

N = 1040.507 + 5258.95 ≈ 6300

Area: A = 50 × 100 = 5000 mm²

σc =

N
A

=

6300
5000

### = 1.259 MPa

### Compare to yield: ƒy = 250 Mpa

### Compressive stress is very Small – Safe

### 10.Combined Stress:

σb

ƒy

+

σc

ƒy

=

9.42
250

+

1.259
250

= 0.0427

### 0.0427 < 1.0 = Safe

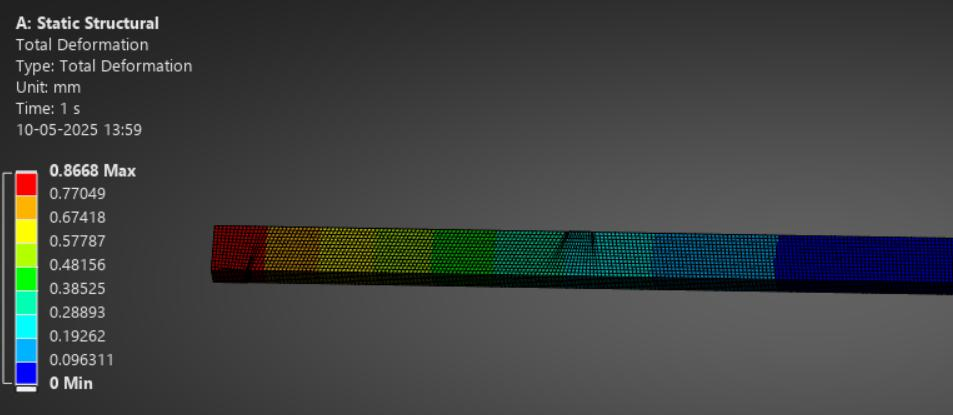
[picture p18: figure]

Fig no 21: Simulation Result of Crane Boom

### 11.Frame Design:

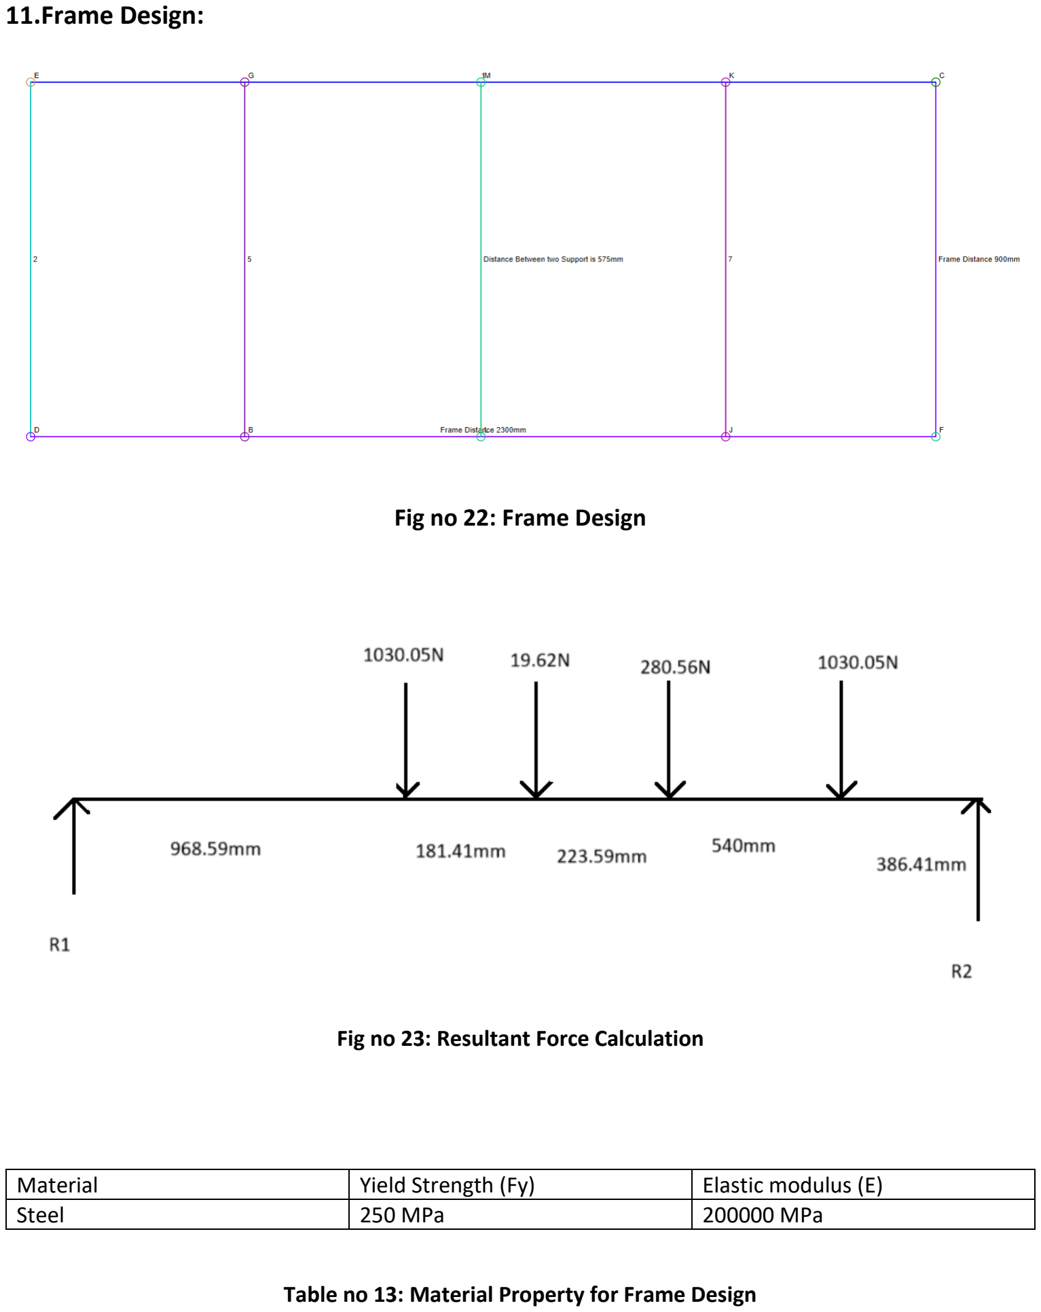
[picture p19: page 35]

### Fig no 22: Frame Design

Fig no 23: Resultant Force Calculation

Material | Yield Strength (Fy) | Elastic modulus (E)
Steel | 250 MPa | 200000 MPa

Table no 13: Material Property for Frame Design

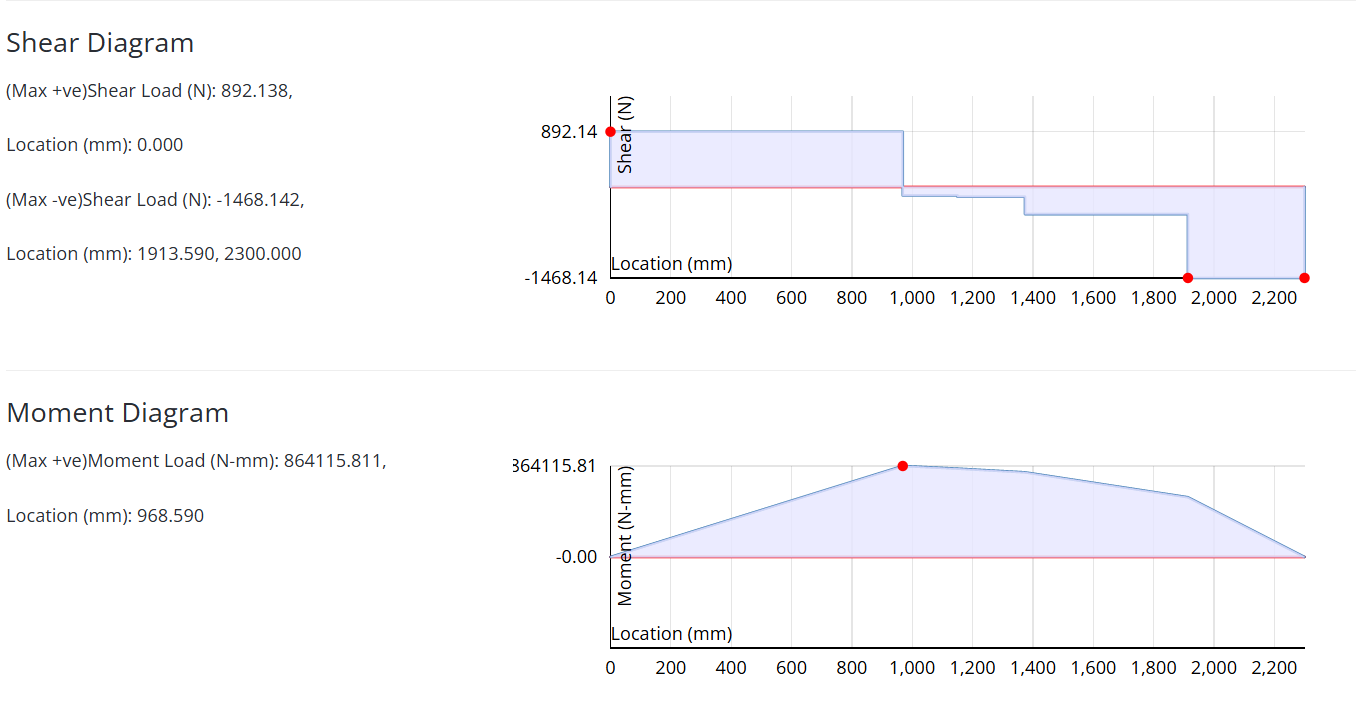
[picture p20: figure]

Fig no 24: SFD and BMD

### 1. Finding Reaction and Moment

⅀MR1 =(1030.05 × 968.59) + (19.62 × 1150) + (280.56 × 1373.59) + (1030.05 × 1913.59) – (R2×2300)

R2 =

3376726.919
2300

= 1468.14N

R1 = (2360.28-1468.14) = 892.14N

### Maximum Bending Moment = 864115.811 N.mm

### 2. Beam Section Design

### Assume b = 50mm

### Finding required height h:

σb =

M
Z

, Z =

bℎ

2

6

, h = √
6M

b×σallow

### σallow = 150MPa

h = √
6×864115.811
50×150

= √691.292 = 26.29mm

This height is surprisingly small due to low loads — we’ll increase to 60 mm height for stiffness and safety margin.

### 3. Check Stress with Final Dimensions

### Use:

### b = 50mm

### h = 60mm

### Section Modulus:

Z = bℎ

2

6

=

50×60²

6

### = 30000mm³

### Maximum Bending Stress:

σb =

Mmax
Z

=

864115.811
30000

### = 28.80 MPa << 250 MPa (Safe)

### 4. Shear Force and Stress

### Maximum Shear Force:

### Vmax = 892.14 N

### Shear Stress:

τ =

V
A

=

892.14
50 ×60

### = 0.297 MPa << 145 MPa (Safe)

### 5. Deflection

### Maximum Deflection:

### Δmax = 7.56mm – (at 2300mm)

Δallow =

L
180

=

2300
180

### = 12.78mm (Safe)

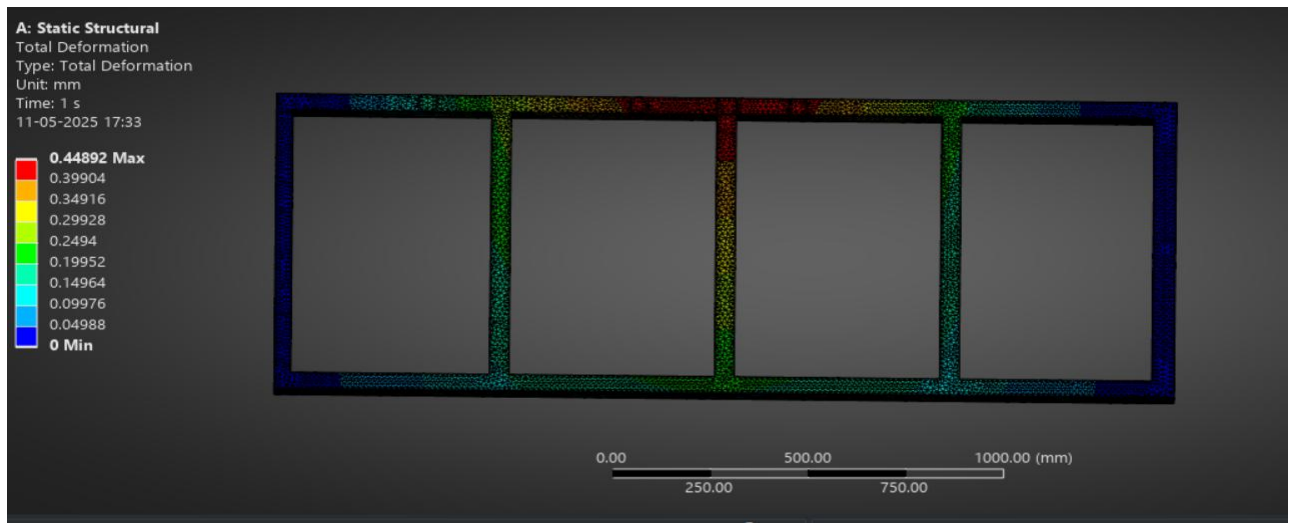
[picture p21: figure]

Fig no 25: Simulation Result of Frame

### 12.Tension Bar

Tensile Force Acting on the Tension Bar

F = 5485.67 N

L = 2237.32mm

Let's assume the Bar is made of Mild Steel with an allowable Tensile Stress σallow = 150 MPa

σ =

F
A

; A = F σallow

A = 5485.67
150 | = 36.571 mm²

Let’s assume Width b = 6mm, then

h = A
b

=

36.571
6 | = 6.10 mm

For using Bolt Pin for Attachment, we Use b = h = 15mm.

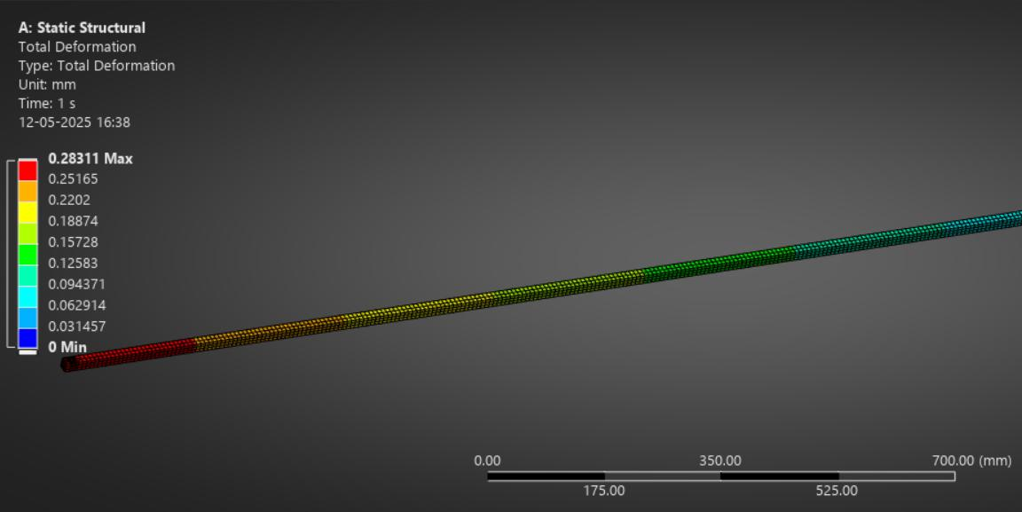
[picture p22: figure]

Fig no 26: Simulation Result of Tension Bar

### 13. Bolt Pin:

### Requirement:

### Length: 70 mm

### Shear Force: 5485.67 N

### Material: Mild Steel = 75 MPa

### τallow = 75 MPa

### Shear Stress on Circular Cross-Section

τ =

F
A

=

4F
πd²
d = √
4F

π×τallow

d = √
4×5485.67
π ×75

= 9.65mm

d ≈ 10 mm.

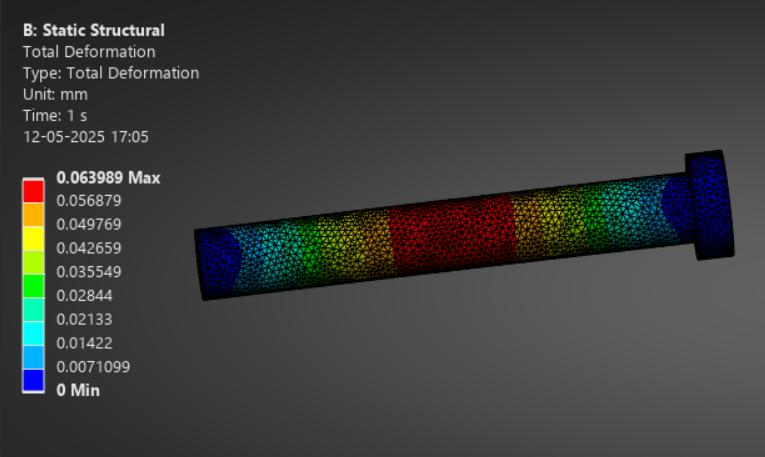
[picture p23: figure]

### Fig no 27: Simulation Result of Tension Pin

### 14. Three Hinge Mechanism

### Comparison of Different Hitch based on HP

Category | Tractor HP | Approximate Max Weight
Category 0 | Up to 20 | 500 Pounds
Category 1 | 20-50 | 2000 Pounds
Category 2 | 50-125 | 5000 Pounds
Category 3 | 100-225 | 15000 Pounds
Category 4 | 200-400 | 20000 Pounds

### Table no 14: Comparison of Different Hitch Based on HP

Category | Upper link hole diameter | Upper link pin diameter | Lower link hole diameter | Lower link pin diameter | Lower hitch point span | Mast Height
Category 0 | 20.32 mm or 51/64 inch | 15.87 mm or 5/8 inch | 22.86 mm or 9/10 inch | 22.22 mm or 7/8 inch | 508 mm or 20 inches | 304.8 mm or 12 inches
Category 1 | 25.65 mm or 1.01 inches | 19.05 mm or 3/4 inch | 28.70 mm or 1.13 inches | 27.94 mm or 1.10 inches | 660.4 mm or 26 inches | 381 mm or 15 inches
Category 2 | 25.65 mm or 1.01 inches | 25.4 mm or 1 inch | 28.70 mm or 1.13 inches | 27.94 mm or 1.10 inches | 825 mm or 32.48 inches | 610.11 mm or 24.02 inches
Category 3 | 32.00 mm or 1.26 inches | 31.75 mm or 1.25 inches | 37.34 mm or 1.47 inches | 36.58 mm or 1.44 inches | 964.95 mm or 37.99 inches | 685.04 mm or 26.9 inches

### Table no 15: Based on Category of Three Point Hitch Design

Category 1 | 25.65mm | 19.05mm | 28.70mm | 27.94mm | 660.4mm | 381mm

### Table no 16: Category 1 for Frame Design

### Shear Force in Hitch Point V = 2000 N

### Allowable Shear Stress τallow = 60 MPa

### Section Shape: Rectangular (width b, height h)

### Shear Area Required

τ =

V
A

: A =

V

τallow

A =

2000
60×10⁶

### = 3.33 × 10⁻⁵ m² = 33.33mm²

### Choose Dimensions

### b × h = A > 33.33 mm²

### b = 4 mm, h = 10 mm: A = 40 mm²

### Shear Stress = ²⁰⁰⁰

40

### = 50 MPa < 60 MPa

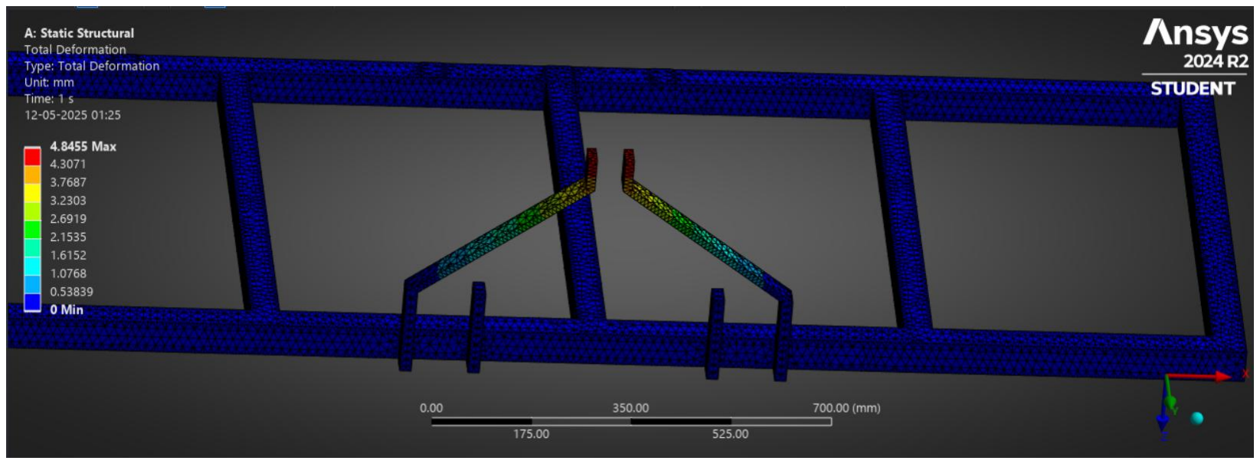
[picture p24: figure]

### Fig no 29: Simulation Result of Three Point Hinch

### 15. Design for Hinge Pin

### Requirement Data:

### Shear Force V = 2000 N

### Length= 110mm

### Material: Mild Steel (τallow = 60MPa)

### 1. Shear Stress in a Circular Cross Section

τ =

V
A

=

V
πd2
4

→ d = √
4V

πτallow

### 2. BY Putting the Values

d = √
4×2000
π×60×10⁶

=√
8000
188.5×10⁶

= 6.51 mm

### For Safe and Manufacturable we choose Standard Size d = 8 mm

### 16.Frame Stand:

Width (b) = 40mm
Height (h) = 40mm

Length = 450mm

Bolt Hole Diameter = 16mm

Hollow Inner:
Width (b) = 20mm
Height (h) = 20mm

### Load = (150×9.81) = (1471.5/2) = 735.75 N

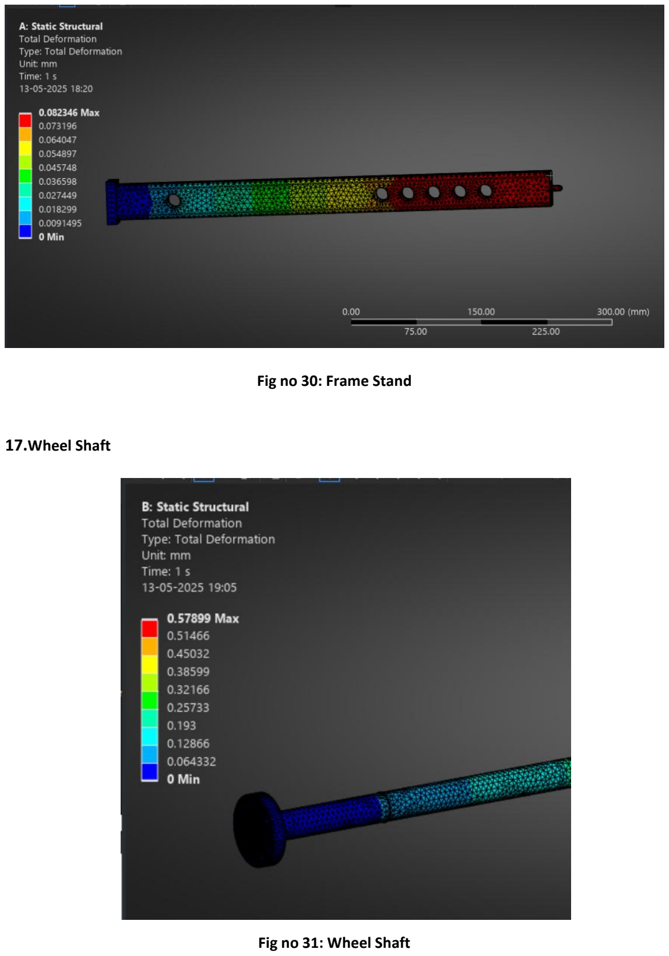
[picture p25: page 43]

### Fig no 30: Frame Stand

### 17.Wheel Shaft

### Fig no 31: Wheel Shaft

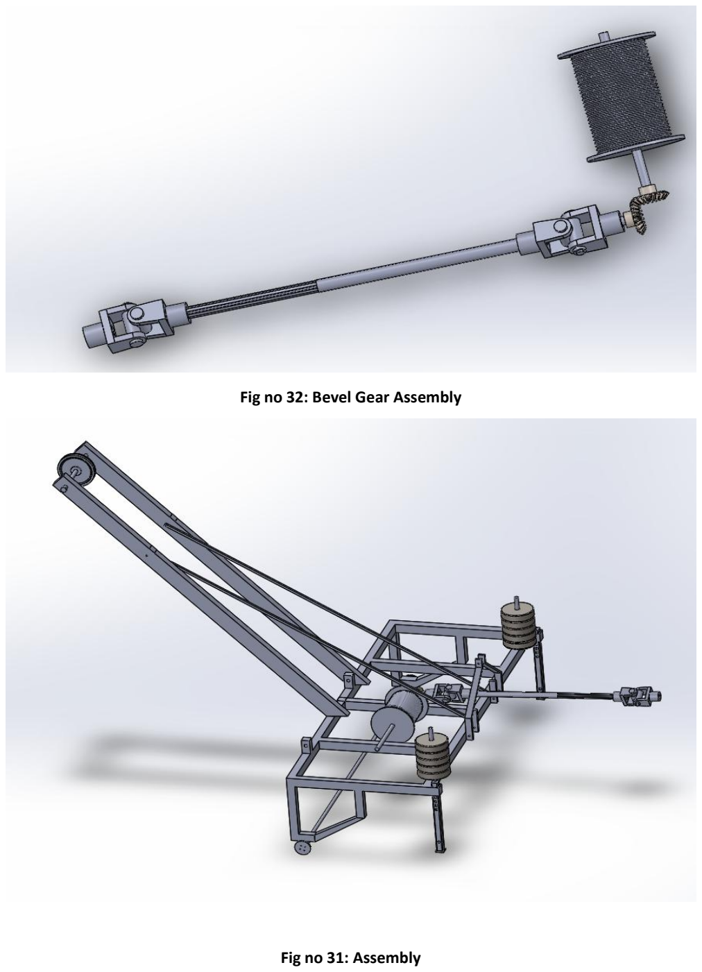
[picture p26: page 44]

### Fig no 32: Bevel Gear Assembly

### Fig no 31: Assembly

### 18.References

1. Jinping Li; Lin Bai; Wei Gao. Reliability-based design optimization for the lattice boom of crawler crane. Institution of Structural Engineers. Published by Elsevier Ltd, December 2020, 1111–1118. [CrossRef] (https://doi.org/10.1016/j.istruc.2020.12.024)
2. Anh Le; Tuan; Soon-Geul Lee. Modeling and advanced sliding mode controls of crawler cranes considering wire rope elasticity and complicated operations. Mechanical System and Signal Processing, 2018, 250-263. [CrossRef] (https://doi.org/10.1016/j.ymssp.2017.09.045)
3. Sanaz Sadeghi; Nazi Soltanmohammadlou ; Payam Rahnamayiezekavat. A systematic review of scholarly works addressing crane safety requirements. Safety Science Elsevier, January 2021, Volume 133, 105002. [CrossRef] (https://doi.org/10.1016/j.ssci.2020.105002)
4. C J Hall. Design, Practice and Maintenance. Professional Engineering Publishing Limited London and Bury St Edmunds, UK, 2002. [CrossRef] (https://www.wiley.com/en-us/Cranes%3A+Design%2C+Practice%2C+and+Maintenance%2C+2nd+Edition-p-9781860583735)
5. Yajuan Kang; Shaojun Liu; Weisheng Zou. Design and analysis of an innovative deep-sea lifting motor pump. Applied Ocean Research Elsevier, November 2018, 82, 22-31. [CrossRef] (https://doi.org/10.1016/j.apor.2018.10.018)
6. Peter Kayode Farayibi; Taiwo Ebenezer Abioye. Development of an automated mechanical lift for material handling purposes. African Journal of Science Technology Innovation and Development. June 2020. [CrossRef] (https://www.researchgate.net/publication/342155446_Development_of_an_automated_mechanical_lift_for_material_handling_purposes)
7. Y Fei; J Jiang; C Sun. Analysis of the influence on the hydraulic lifting circuit of the boom crane when the characteristics of the steel wire rope changes. IOP Conf. Series: Materials Science and Engineering 1009. 2021. [CrossRef] (https://www.researchgate.net/publication/348549539_Analysis_of_the_influence_on_the_hydraulic_lifting_circuit_of_the_boom_crane_when_the_characteristics_of_th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)
8. Atul Gade; Mahesh Yadav; Vrushali Dharme. Design And Development of Bore Well Pump Lifting Mechanism. Journal of Emerging Technologies and Innovative Research (JETIR). April 2019, Volume 6, Issue 4.[CrossRef] (https://www.jetir.org/papers/JETIR1904995.pdf)
9. Hayder Kadhim Khashan. Design and Development of Wind Power Water Lifting Pump Mechanism. International Journal of Science Technology & Engineering, Volume 2, Issue 12, June 2016. [CrossRef] (https://ijste.org/articles/IJSTEV2I12236.pdf)
10. Mayur N; Adhude; Sharad S; Chaudhari. An Overview of Bore Well Motor Pump Installation and Lifting Machine. International Journal for Scientific Research & Development, 2015, Vol. 3, Issue 08. [CrossRef] (https://ijsrd.com/articles/IJSRDV3I80018.pdf)
11. Suraj M. Namde; Akshay P. Yadav; Chhaya M. Kakade. Design and Fabrication of Submersible Pump Lifting Machine. Journal of Industrial Mechanics, 2019, Volume 4 Issue 1. [CrossRef] (https://matjournals.co.in/index.php/JoIM/article/view/6485)
12. Akshay M. Bajbalkar; Mahaling R. Bhajibhakare; Mr. Nikhil P. Ambole. Review on Modeling of Mechanism for Installation and Lifting of Bore Well Pipe and Submersible Pump. IJARIIE-ISSN(O)-2395-4396, 2019, Vol-5 Issue-
2. [CrossRef] (https://ijariie.com/AdminUploadPdf/Review_on_Modeling_of_Mechanism_for_Installation_and_Lifting_of_Bore_Well_Pipe_and_Submersible_Pump_ijariie9894.pdf)
13. Cong, Q.; Yang, Z.; Xu, J.; Ma, B.; Chen, T.; Zhang, X.; Wang, L.; Ru, S. Design and Test of Load-Lifting Performance for Hydraulic Linkage of the High-Medium Horsepower Tractor. Applied Science, 2021, 11, 9. [CrossRef] (https://www.mdpi.com/2076-3417/11/20/9758)
14. Javad Tarighi; Hamid Reza Ghasemzadeh; Manochehr Bahrami. Optimization of a Lower Hitch Link for a Heavy-Duty Tractor Using Finite Element Method. J Fail. Anal. and Preven, 2016, 16:123–128. [CrossRef] (https://www.researchgate.net/publication/288920111_Optimization_of_a_Lower_Hitch_Link_for_a_Heavy_Duty_Tractor_Using_Finite_Element_Method)
15. Esmaeel Seyedabadi. Finite Element Analysis of Lift Arm of a MF-285 Tractor Three-Point Hitch. J Fail. Anal. and Preven, 2015. [CrossRef] (https://link.springer.com/article/10.1007/s11668-015-0010-0)
16. H. Bentahera; E. Hamzab; G. Kantchevc; A. Maalej. Three-point hitch-mechanism instrumentation for tillage power optimization. Power and Machinery Biosystems Engineering 100, 2008, 24–30. [CrossRef]
17. Choure Bhagvanta; kale Ganesh; Dhanwate Prashant; Dhat Prashant. Review on Bore Well Pipe Lifting and Transportation Machine. IJAR E-ISSN(O)-2395-4396, 2018, Vol-4 Issue-2. [CrossRef] (https://ijariie.com/AdminUploadPdf/Review_on_Bore_Well_Pipe_Lifting_and_Transportation_Machine_ijariie8295.pdf)
