Prajwal-Chandrashekhar-Wani/Pump-Lifting-Mechanism-/AssenblyBevelSub.SLDASM

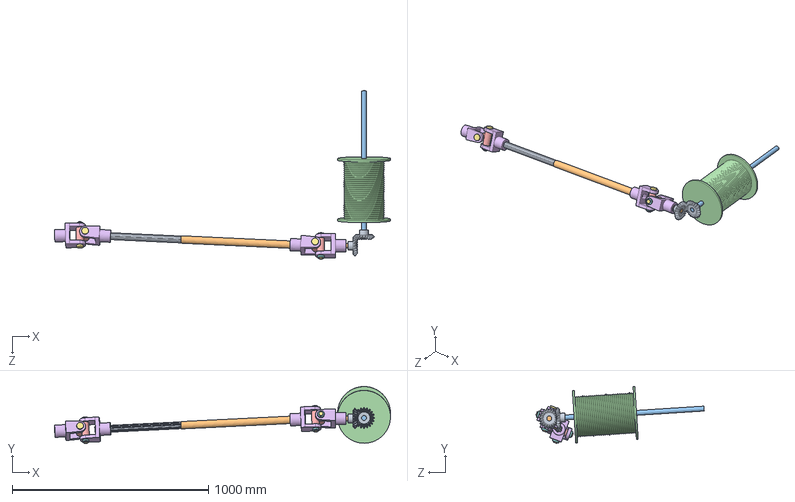
[picture p27: CAD file, 2025-05-15]
AssenblyBevelSub.SLDASM
1714.0 x 290.9 x 859.8 mm
BevelGear x 2
Pto bevel gear mechanism
Main Shaft
Drum
CenterBlock x 2
Fork x 4
Rod x 4
CotterPin x 4
MainSplinerod
OuterShaft
