Prajwal-Chandrashekhar-Wani/Pump-Lifting-Mechanism-/AssenblyBevel.SLDASM

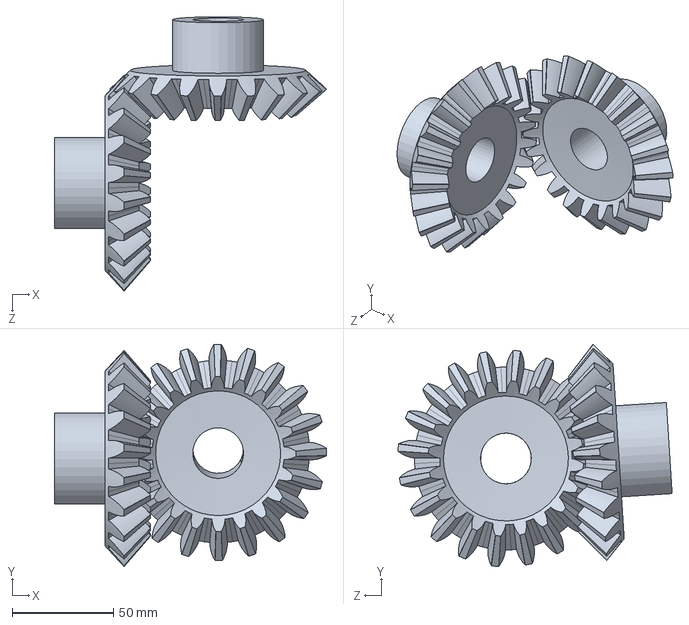
[picture p28: CAD file, 2025-05-15]
AssenblyBevel.SLDASM
134.0 x 109.5 x 135.2 mm
BevelGear x 2
