Prajwal-Chandrashekhar-Wani/Pump-Lifting-Mechanism-/Assem2.SLDASM

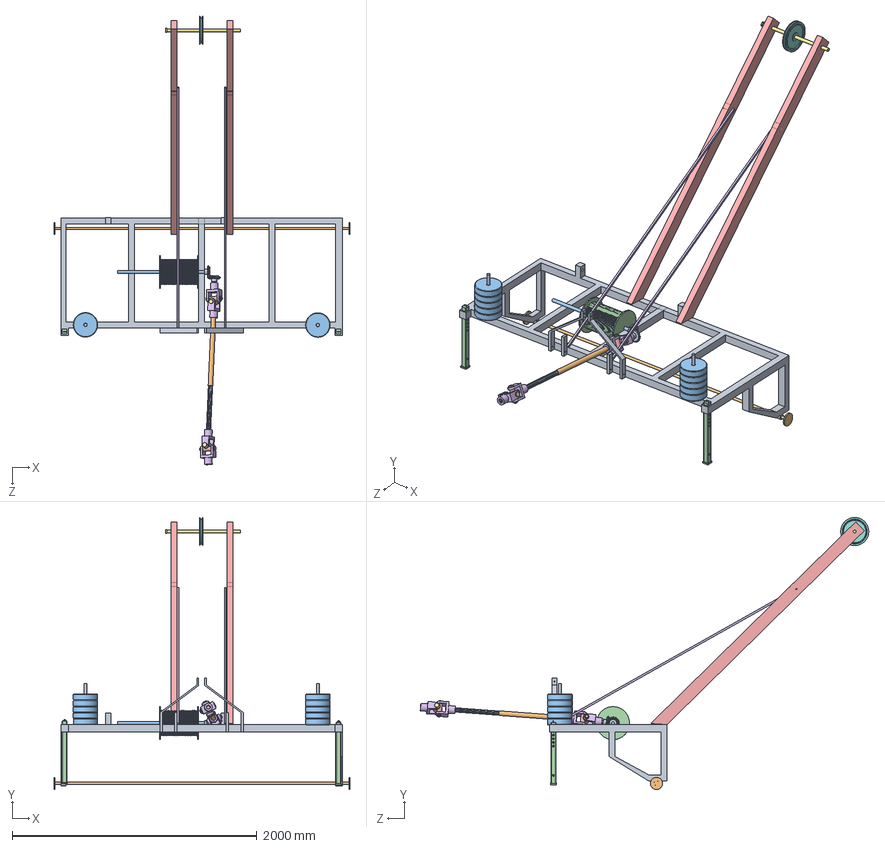
[picture p29: CAD file, 2025-05-15]
Assem2.SLDASM
2420.0 x 2224.3 x 3667.0 mm
Framewithhitch
Wheel Rod
WeightBlock x 11
FrameStand x 2
CraneBoom x 2
Tension_Bar x 2
PulleyPin
Pulley
BevelGear x 2
Pto bevel gear mechanism
Main Shaft
Drum
CenterBlock x 2
Fork x 4
Rod x 4
CotterPin x 4
MainSplinerod
OuterShaft
