Prajwal-Chandrashekhar-Wani/Pump-Lifting-Mechanism-/MainSplinerod.SLDPRT

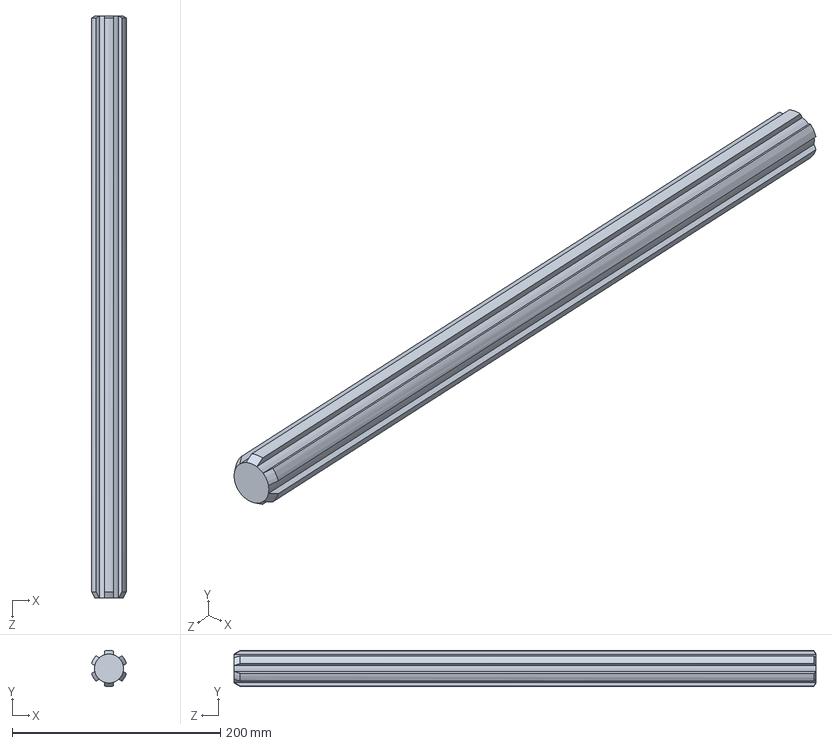
[picture p30: CAD file, 2025-05-15]
MainSplinerod.SLDPRT
33.6 x 34.9 x 558.8 mm
