Prajwal-Chandrashekhar-Wani/Pump-Lifting-Mechanism-/Main Shaft.SLDPRT

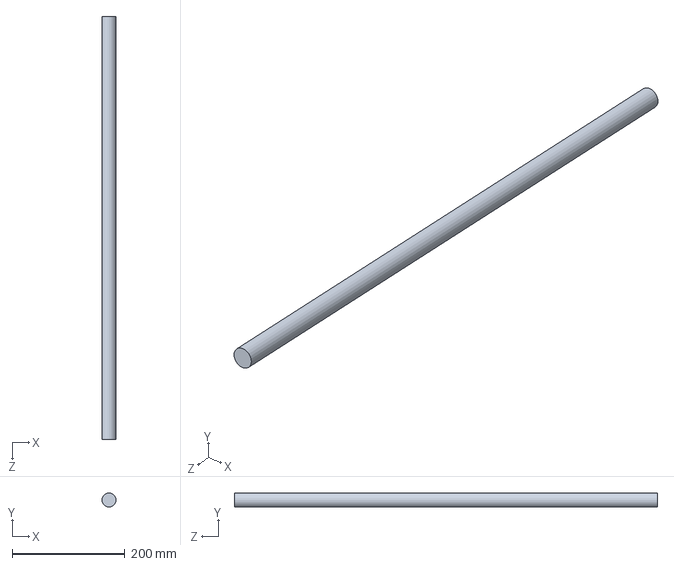
[picture p31: CAD file, 2025-05-15]
Main Shaft.SLDPRT
25.0 x 25.0 x 750.0 mm
