Prajwal-Chandrashekhar-Wani/Pump-Lifting-Mechanism-/Framewithhitch.SLDPRT

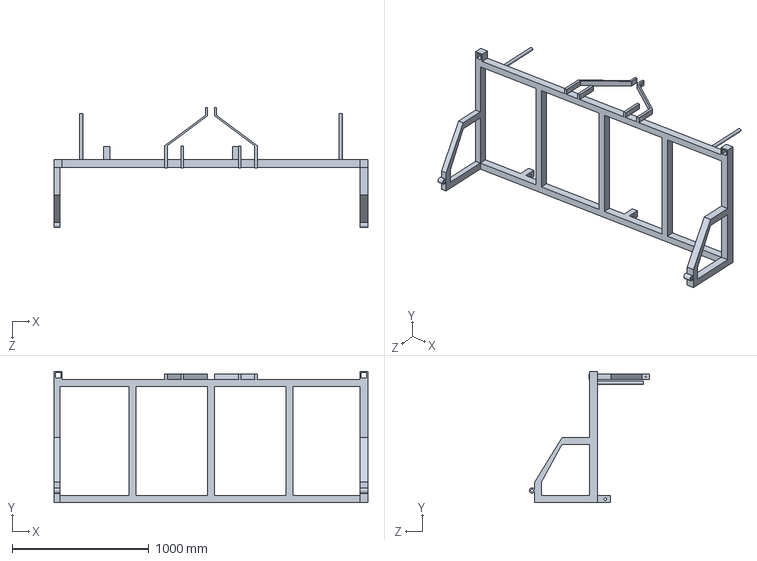
[picture p32: CAD file, 2025-05-15]
Framewithhitch.SLDPRT
2300.0 x 962.4 x 882.1 mm
