Prajwal-Chandrashekhar-Wani/Pump-Lifting-Mechanism-/Pulley.SLDPRT

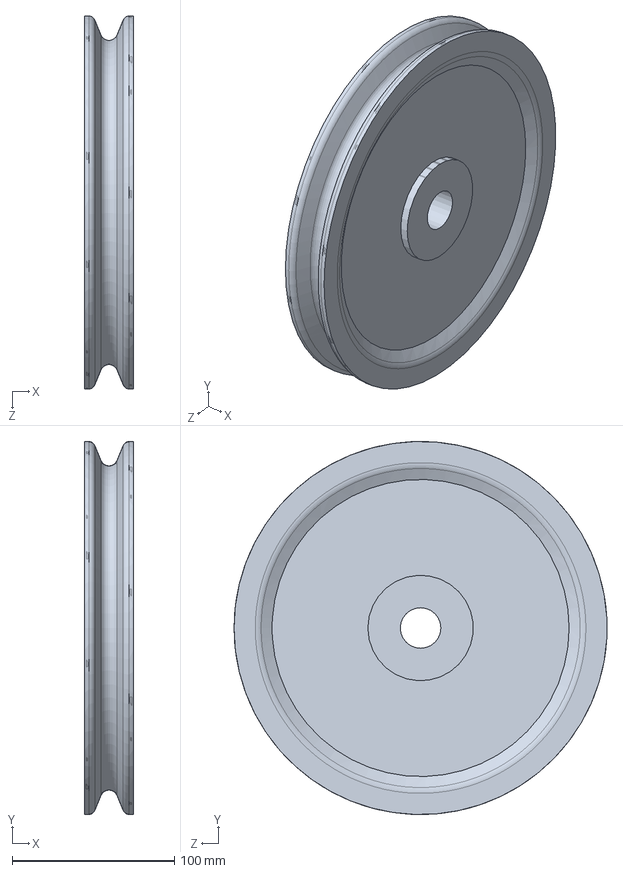
[picture p33: CAD file, 2025-05-15]
Pulley.SLDPRT
30.0 x 229.9 x 229.9 mm
