Prajwal-Chandrashekhar-Wani/Pump-Lifting-Mechanism-/CraneBoom.SLDPRT

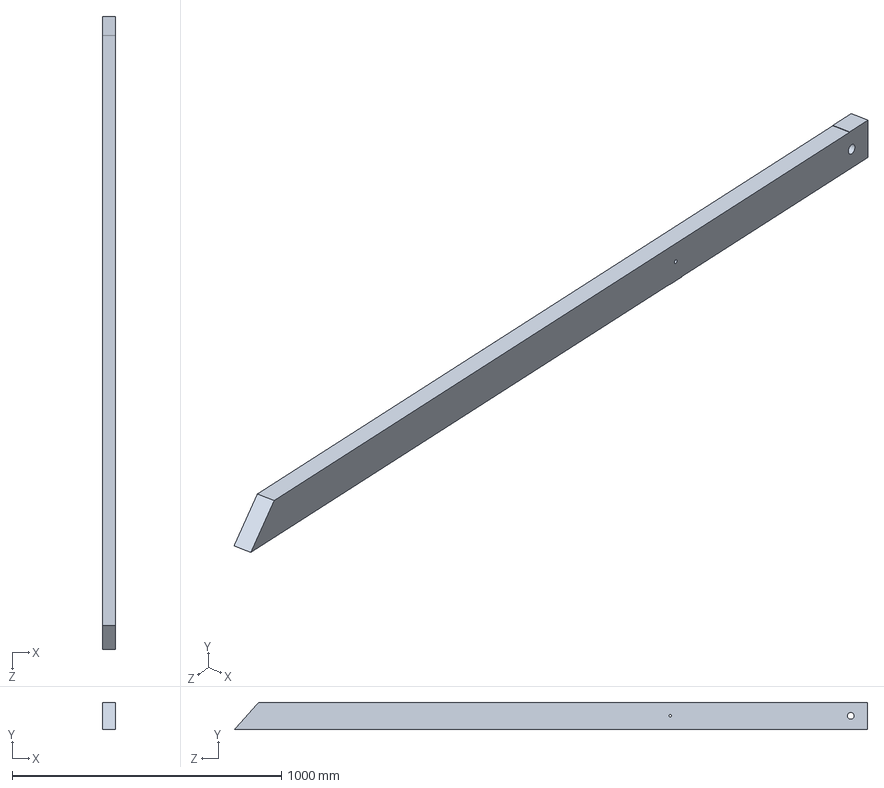
[picture p34: CAD file, 2025-05-15]
CraneBoom.SLDPRT
50.0 x 102.0 x 2351.8 mm
