Prajwal-Chandrashekhar-Wani/Pump-Lifting-Mechanism-/Frame.SLDPRT

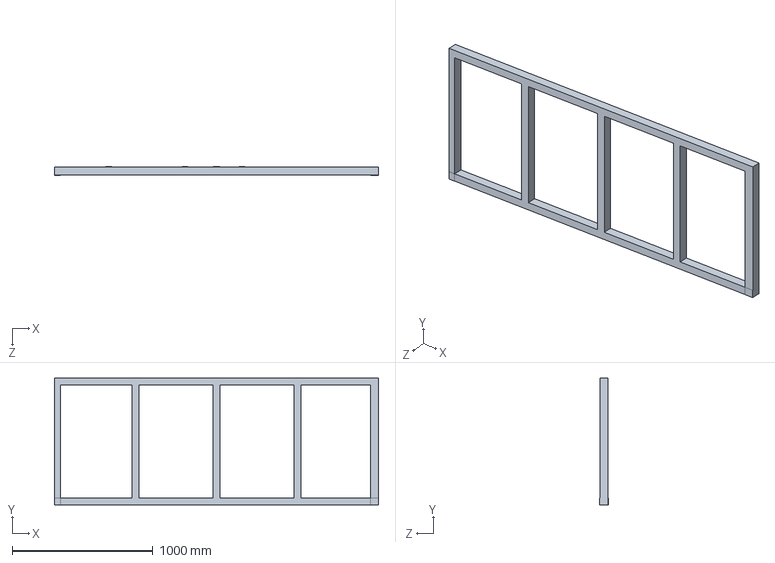
[picture p35: CAD file, 2025-05-15]
Frame.SLDPRT
2300.0 x 900.5 x 62.0 mm
