Prajwal-Chandrashekhar-Wani/Pump-Lifting-Mechanism-/PulleyPin.SLDPRT

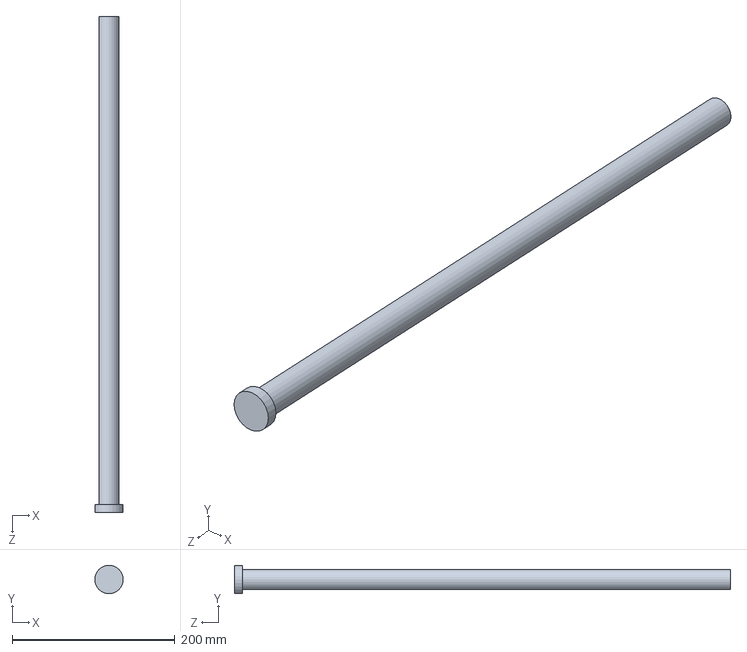
[picture p36: CAD file, 2025-05-15]
PulleyPin.SLDPRT
35.0 x 35.0 x 610.0 mm
