Prajwal-Chandrashekhar-Wani/Pump-Lifting-Mechanism-/Pto bevel gear mechanism.SLDPRT

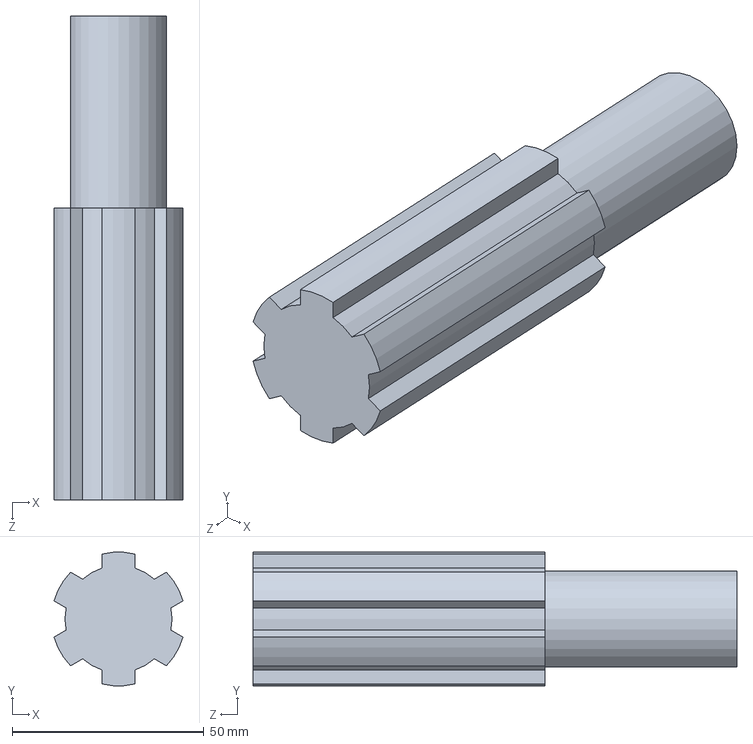
[picture p37: CAD file, 2025-05-15]
Pto bevel gear mechanism.SLDPRT
33.6 x 34.8 x 126.0 mm
