Prajwal-Chandrashekhar-Wani/Pump-Lifting-Mechanism-/Drum.SLDPRT

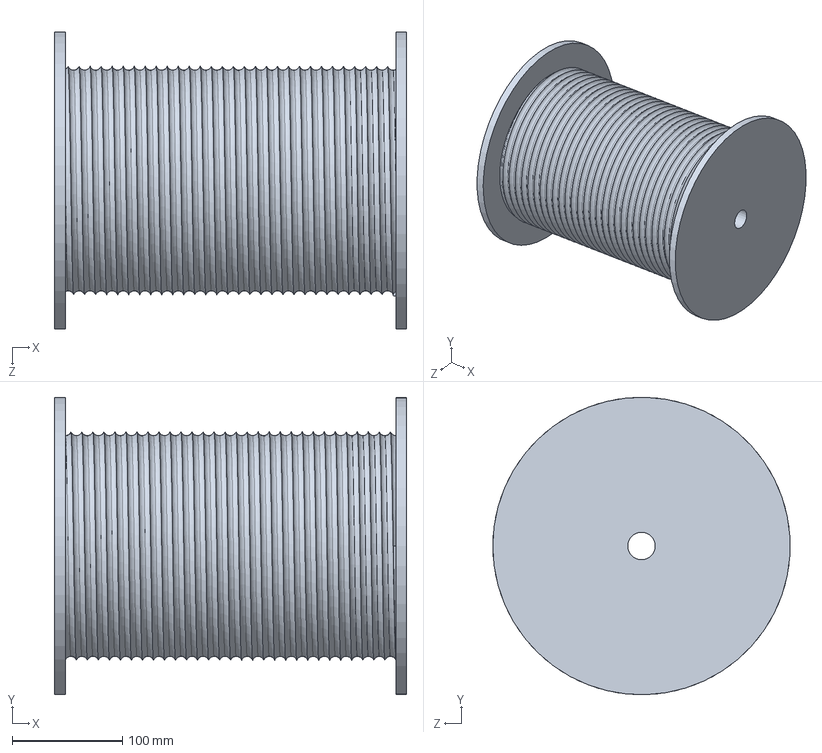
[picture p38: CAD file, 2025-05-15]
Drum.SLDPRT
319.5 x 269.8 x 270.0 mm
