Prajwal-Chandrashekhar-Wani/Pump-Lifting-Mechanism-/BevelGear.SLDPRT

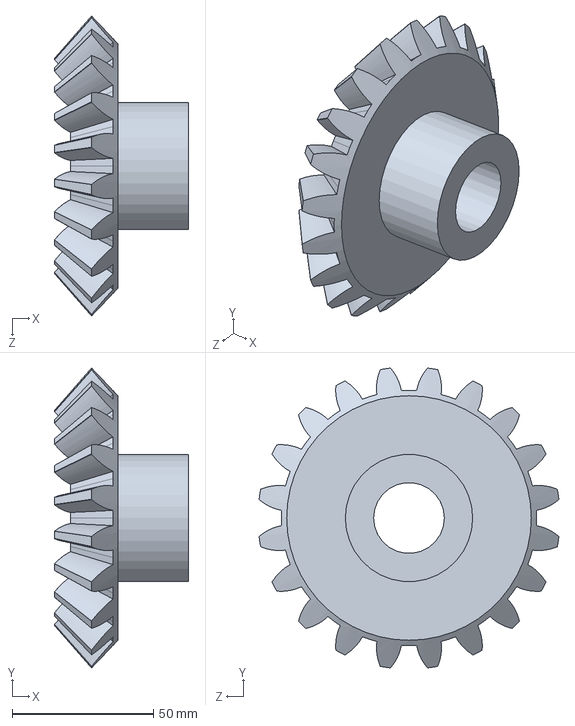
[picture p39: CAD file, 2025-05-15]
BevelGear.SLDPRT
47.4 x 106.0 x 106.0 mm
