Prajwal-Chandrashekhar-Wani/Pump-Lifting-Mechanism-/OuterShaft.SLDPRT

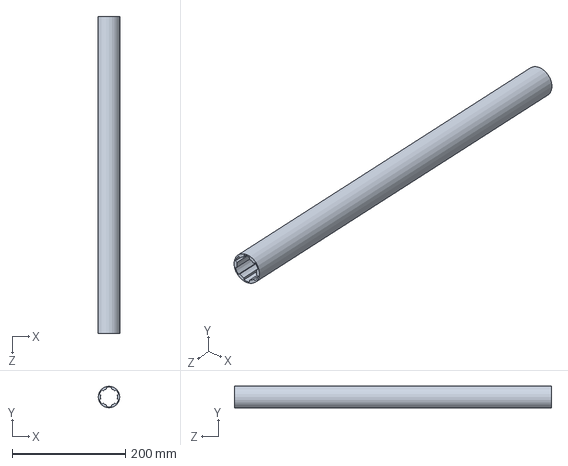
[picture p40: CAD file, 2025-05-15]
OuterShaft.SLDPRT
38.1 x 38.1 x 558.8 mm
