Prajwal-Chandrashekhar-Wani/Pump-Lifting-Mechanism-/FrameStand.SLDPRT

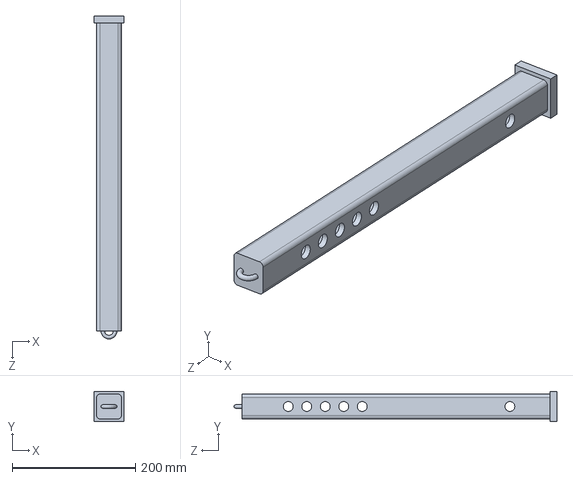
[picture p41: CAD file, 2025-05-15]
FrameStand.SLDPRT
49.3 x 49.1 x 524.0 mm
