Prajwal-Chandrashekhar-Wani/Pump-Lifting-Mechanism-/(list of files, cad)

Other CAD files:
AssenblyBevel.IGS
BevelGear.IGS
Drum.IGS
Frame.IGS
FrameStand.IGS
Framewithhitch.IGS
Pulley.IGS
PulleyPin.IGS
